Chi68P1/Tennis_Ball_Retrieval_Robot_Project/SW_simulate_ROS/catkin_ws/src/my_robot/meshes/main_wheel.stl

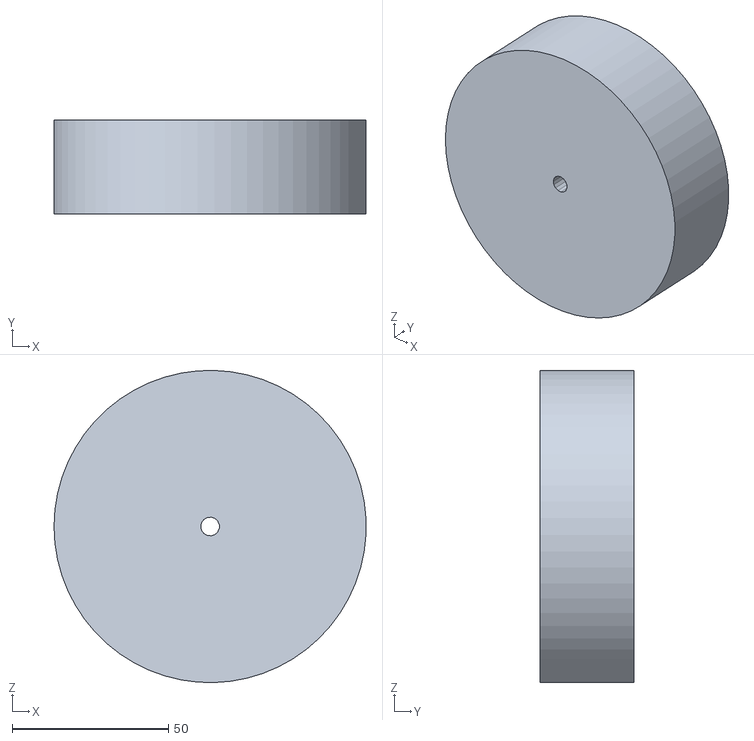
[picture p57: CAD file, 2024-01-08]
SW_simulate_ROS/catkin_ws/src/my_robot/meshes/main_wheel.stl
99.9 x 30.0 x 100.0
