Chi68P1/Tennis_Ball_Retrieval_Robot_Project/SW_simulate_ROS/catkin_ws/src/my_robot/meshes/base1.stl

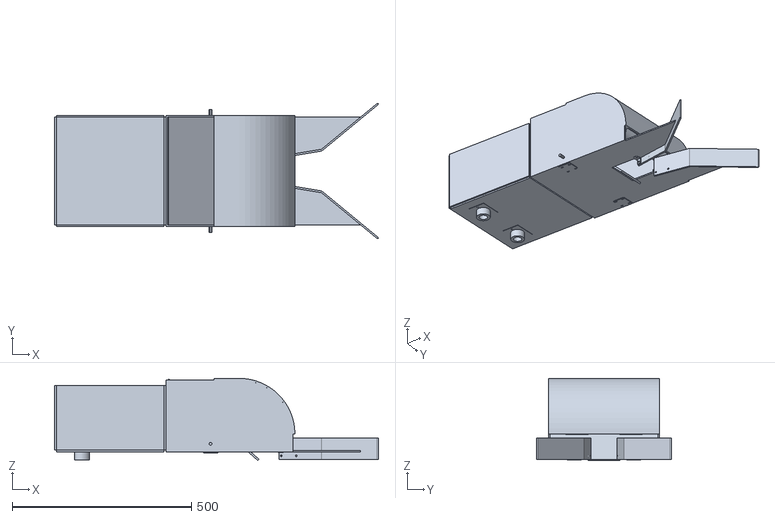
[picture p58: CAD file, 2024-01-08]
SW_simulate_ROS/catkin_ws/src/my_robot/meshes/base1.stl
902.8 x 377.0 x 229.2
