Chi68P1/Tennis_Ball_Retrieval_Robot_Project/SW_simulate_ROS/catkin_ws/src/my_robot/meshes/oriented_wheel.stl

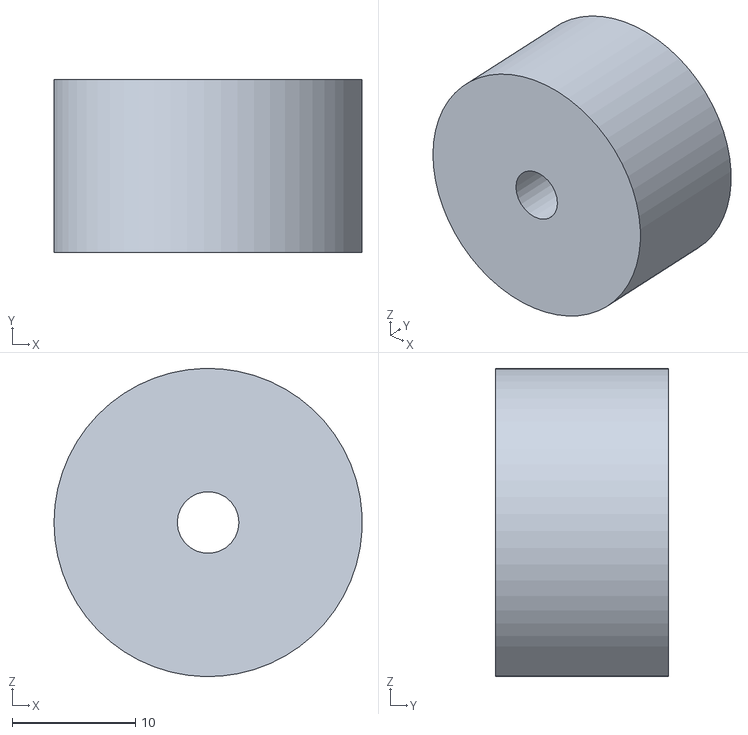
[picture p59: CAD file, 2024-01-08]
SW_simulate_ROS/catkin_ws/src/my_robot/meshes/oriented_wheel.stl
25.0 x 14.0 x 25.0
