Chi68P1/Tennis_Ball_Retrieval_Robot_Project/SW_simulate_ROS/catkin_ws/src/my_robot/meshes/base0.stl

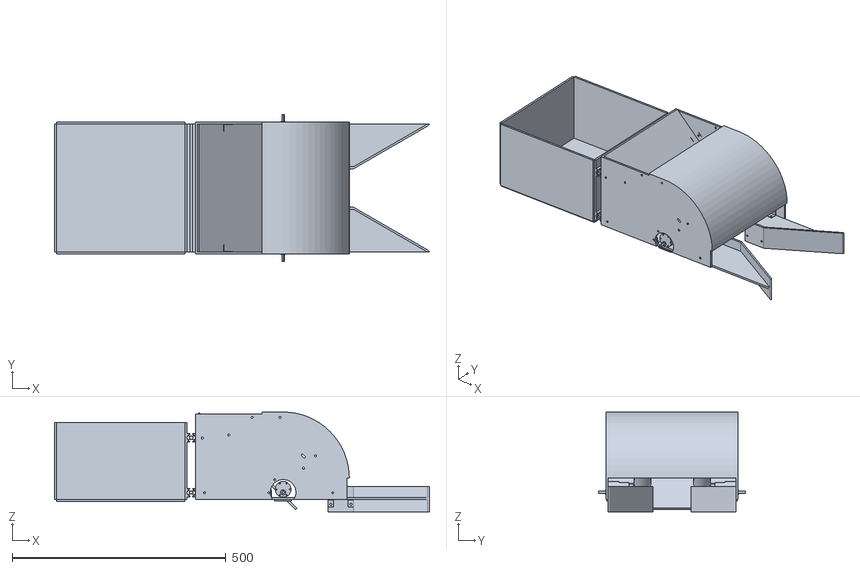
[picture p60: CAD file, 2024-01-08]
SW_simulate_ROS/catkin_ws/src/my_robot/meshes/base0.stl
877.5 x 343.0 x 234.0
