Chi68P1/Tennis_Ball_Retrieval_Robot_Project/SW_simulate_ROS/catkin_ws/src/my_robot/meshes/oriented_link1.stl

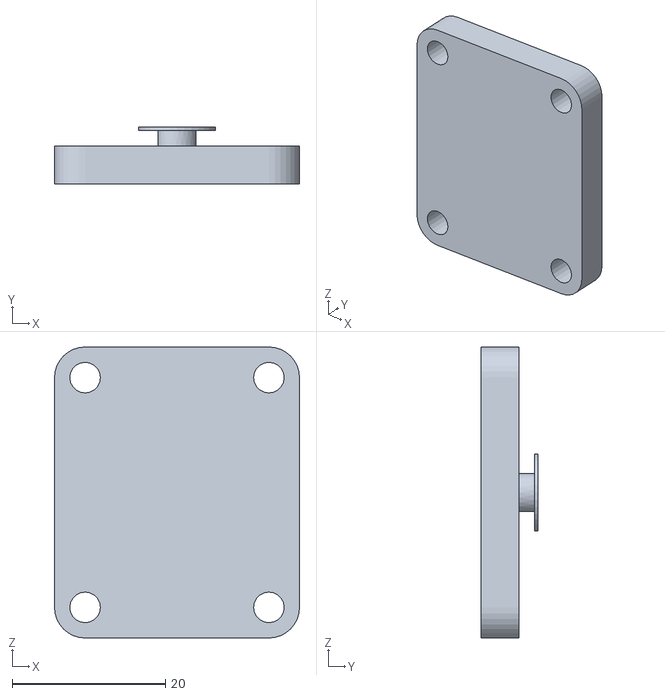
[picture p61: CAD file, 2024-01-08]
SW_simulate_ROS/catkin_ws/src/my_robot/meshes/oriented_link1.stl
32.0 x 7.50 x 38.0
