Chi68P1/Tennis_Ball_Retrieval_Robot_Project/SW_simulate_ROS/catkin_ws/src/my_robot/meshes/base3.stl

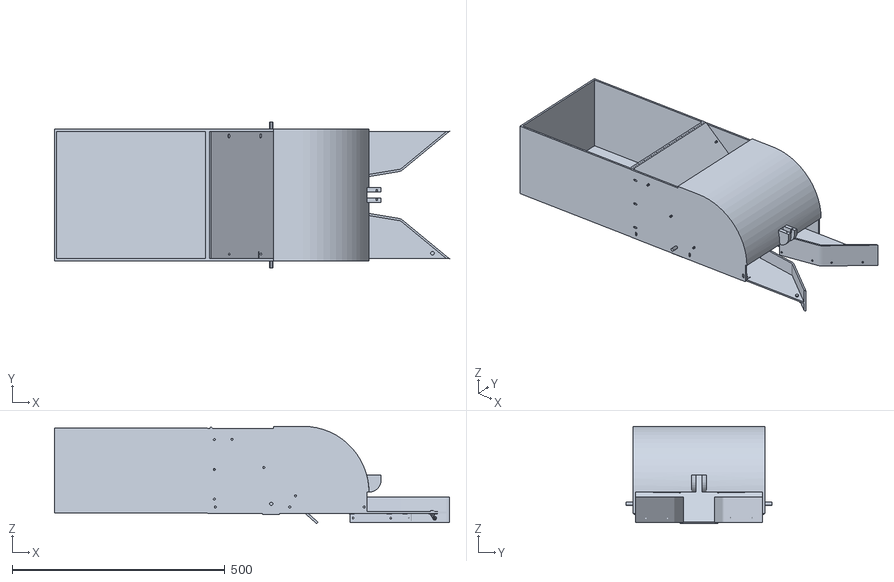
[picture p63: CAD file, 2024-01-08]
SW_simulate_ROS/catkin_ws/src/my_robot/meshes/base3.stl
929.4 x 344.0 x 229.2
