Chi68P1/Tennis_Ball_Retrieval_Robot_Project/SW_simulate_ROS/catkin_ws/src/my_robot/meshes/base2.stl

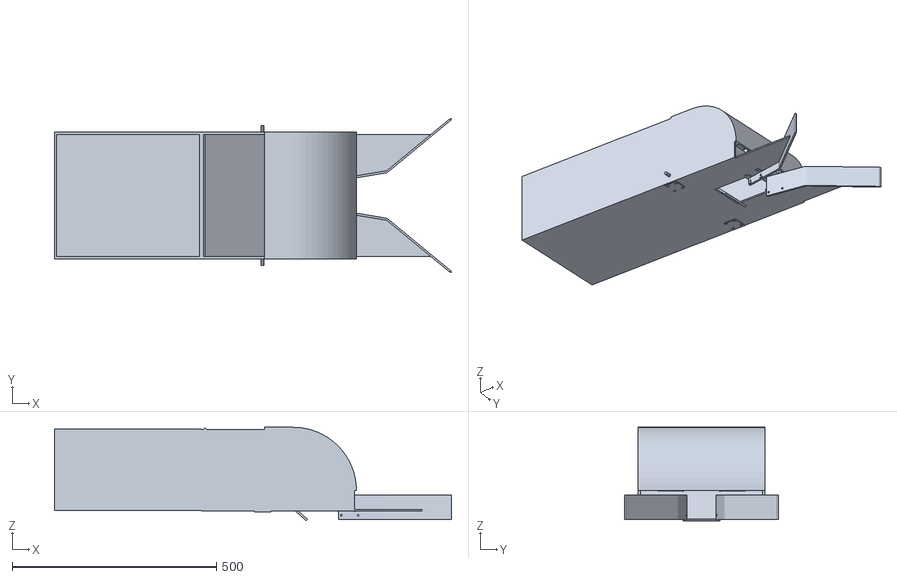
[picture p64: CAD file, 2024-01-08]
SW_simulate_ROS/catkin_ws/src/my_robot/meshes/base2.stl
972.8 x 377.0 x 229.2
