Chi68P1/Tennis_Ball_Retrieval_Robot_Project/SW_simulate_ROS/catkin_ws/src/my_robot/meshes/shooting_wheel.stl

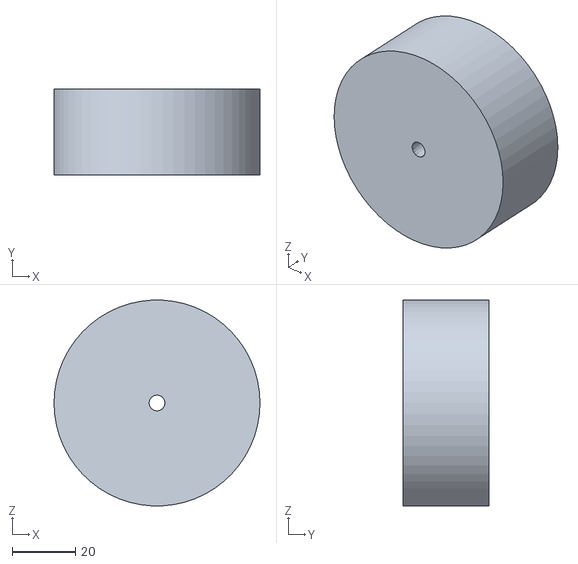
[picture p65: CAD file, 2024-01-08]
SW_simulate_ROS/catkin_ws/src/my_robot/meshes/shooting_wheel.stl
65.0 x 27.0 x 64.9
