Chi68P1/Tennis_Ball_Retrieval_Robot_Project/SW_simulate_ROS/catkin_ws/src/my_robot/meshes/oriented_link2.stl

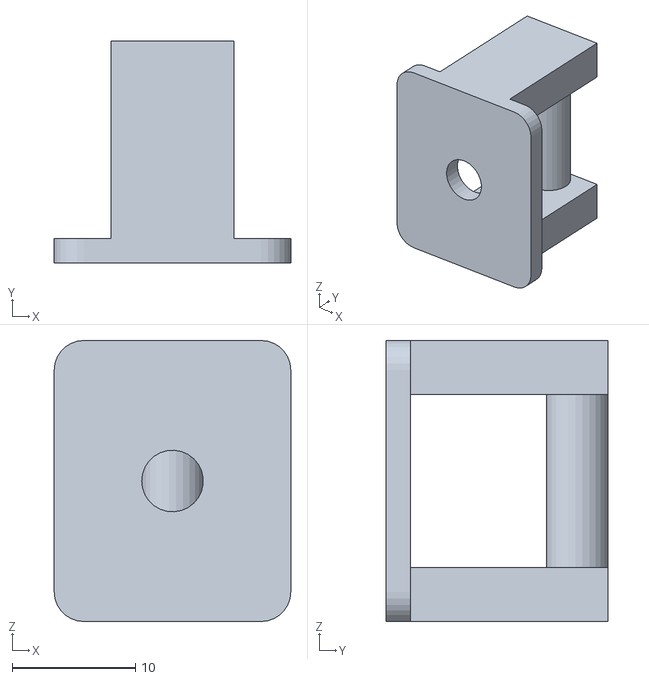
[picture p66: CAD file, 2024-01-08]
SW_simulate_ROS/catkin_ws/src/my_robot/meshes/oriented_link2.stl
19.2 x 18.0 x 22.8
