Chi68P1/Tennis_Ball_Retrieval_Robot_Project/SW_stm32/Manual_stm_1/MDK-ARM/TRR_main/TRR_main.htm

# Static Call Graph for image TRR_main\TRR_main.axf

#<CALLGRAPH># ARM Linker, 5060960: Last Updated: Mon Dec 25 12:03:44 2023

### Maximum Stack Usage = 192 bytes + Unknown(Functions without stacksize, Cycles, Untraceable Function Pointers)

### Call chain for Maximum Stack Depth:

USB_LP_CAN1_RX0_IRQHandler ⇒ HAL_PCD_IRQHandler ⇒ PCD_EP_ISR_Handler ⇒ HAL_PCD_EP_DB_Transmit ⇒ HAL_PCD_DataInStageCallback ⇒ USBD_LL_DataInStage ⇒ USBD_CtlReceiveStatus ⇒ USBD_LL_PrepareReceive ⇒ HAL_PCD_EP_Receive ⇒ USB_EPStartXfer ⇒ USB_WritePMA

### Functions with no stack information

- __user_initial_stackheap

### Mutually Recursive functions

- ADC1_2_IRQHandler ⇒ ADC1_2_IRQHandler
- BusFault_Handler ⇒ BusFault_Handler
- HardFault_Handler ⇒ HardFault_Handler
- MemManage_Handler ⇒ MemManage_Handler
- NMI_Handler ⇒ NMI_Handler
- UART_EndRxTransfer ⇒ UART_EndRxTransfer
- UsageFault_Handler ⇒ UsageFault_Handler

### Function Pointers

- ADC1_2_IRQHandler from startup_stm32f103xb.o(.text) referenced from startup_stm32f103xb.o(RESET)
- BusFault_Handler from stm32f1xx_it.o(i.BusFault_Handler) referenced from startup_stm32f103xb.o(RESET)
- CAN1_RX1_IRQHandler from startup_stm32f103xb.o(.text) referenced from startup_stm32f103xb.o(RESET)
- CAN1_SCE_IRQHandler from startup_stm32f103xb.o(.text) referenced from startup_stm32f103xb.o(RESET)
- CDC_Control_FS from usbd_cdc_if.o(i.CDC_Control_FS) referenced 2 times from usbd_cdc_if.o(.data)
- CDC_DeInit_FS from usbd_cdc_if.o(i.CDC_DeInit_FS) referenced 2 times from usbd_cdc_if.o(.data)
- CDC_Init_FS from usbd_cdc_if.o(i.CDC_Init_FS) referenced 2 times from usbd_cdc_if.o(.data)
- CDC_Receive_FS from usbd_cdc_if.o(i.CDC_Receive_FS) referenced 2 times from usbd_cdc_if.o(.data)
- DMA1_Channel1_IRQHandler from startup_stm32f103xb.o(.text) referenced from startup_stm32f103xb.o(RESET)
- DMA1_Channel2_IRQHandler from startup_stm32f103xb.o(.text) referenced from startup_stm32f103xb.o(RESET)
- DMA1_Channel3_IRQHandler from startup_stm32f103xb.o(.text) referenced from startup_stm32f103xb.o(RESET)
- DMA1_Channel4_IRQHandler from startup_stm32f103xb.o(.text) referenced from startup_stm32f103xb.o(RESET)
- DMA1_Channel5_IRQHandler from startup_stm32f103xb.o(.text) referenced from startup_stm32f103xb.o(RESET)
- DMA1_Channel6_IRQHandler from startup_stm32f103xb.o(.text) referenced from startup_stm32f103xb.o(RESET)
- DMA1_Channel7_IRQHandler from startup_stm32f103xb.o(.text) referenced from startup_stm32f103xb.o(RESET)
- DebugMon_Handler from stm32f1xx_it.o(i.DebugMon_Handler) referenced from startup_stm32f103xb.o(RESET)
- EXTI0_IRQHandler from startup_stm32f103xb.o(.text) referenced from startup_stm32f103xb.o(RESET)
- EXTI15_10_IRQHandler from startup_stm32f103xb.o(.text) referenced from startup_stm32f103xb.o(RESET)
- EXTI1_IRQHandler from startup_stm32f103xb.o(.text) referenced from startup_stm32f103xb.o(RESET)
- EXTI2_IRQHandler from startup_stm32f103xb.o(.text) referenced from startup_stm32f103xb.o(RESET)
- EXTI3_IRQHandler from startup_stm32f103xb.o(.text) referenced from startup_stm32f103xb.o(RESET)
- EXTI4_IRQHandler from startup_stm32f103xb.o(.text) referenced from startup_stm32f103xb.o(RESET)
- EXTI9_5_IRQHandler from startup_stm32f103xb.o(.text) referenced from startup_stm32f103xb.o(RESET)
- FLASH_IRQHandler from startup_stm32f103xb.o(.text) referenced from startup_stm32f103xb.o(RESET)
- HardFault_Handler from stm32f1xx_it.o(i.HardFault_Handler) referenced from startup_stm32f103xb.o(RESET)
- I2C1_ER_IRQHandler from startup_stm32f103xb.o(.text) referenced from startup_stm32f103xb.o(RESET)
- I2C1_EV_IRQHandler from startup_stm32f103xb.o(.text) referenced from startup_stm32f103xb.o(RESET)
- I2C2_ER_IRQHandler from startup_stm32f103xb.o(.text) referenced from startup_stm32f103xb.o(RESET)
- I2C2_EV_IRQHandler from startup_stm32f103xb.o(.text) referenced from startup_stm32f103xb.o(RESET)
- MemManage_Handler from stm32f1xx_it.o(i.MemManage_Handler) referenced from startup_stm32f103xb.o(RESET)
- NMI_Handler from stm32f1xx_it.o(i.NMI_Handler) referenced from startup_stm32f103xb.o(RESET)
- PVD_IRQHandler from startup_stm32f103xb.o(.text) referenced from startup_stm32f103xb.o(RESET)
- PendSV_Handler from stm32f1xx_it.o(i.PendSV_Handler) referenced from startup_stm32f103xb.o(RESET)
- RCC_IRQHandler from startup_stm32f103xb.o(.text) referenced from startup_stm32f103xb.o(RESET)
- RTC_Alarm_IRQHandler from startup_stm32f103xb.o(.text) referenced from startup_stm32f103xb.o(RESET)
- RTC_IRQHandler from startup_stm32f103xb.o(.text) referenced from startup_stm32f103xb.o(RESET)
- Reset_Handler from startup_stm32f103xb.o(.text) referenced from startup_stm32f103xb.o(RESET)
- SPI1_IRQHandler from startup_stm32f103xb.o(.text) referenced from startup_stm32f103xb.o(RESET)
- SPI2_IRQHandler from startup_stm32f103xb.o(.text) referenced from startup_stm32f103xb.o(RESET)
- SVC_Handler from stm32f1xx_it.o(i.SVC_Handler) referenced from startup_stm32f103xb.o(RESET)
- SysTick_Handler from stm32f1xx_it.o(i.SysTick_Handler) referenced from startup_stm32f103xb.o(RESET)
- SystemInit from system_stm32f1xx.o(i.SystemInit) referenced from startup_stm32f103xb.o(.text)
- TAMPER_IRQHandler from startup_stm32f103xb.o(.text) referenced from startup_stm32f103xb.o(RESET)
- TIM1_BRK_IRQHandler from startup_stm32f103xb.o(.text) referenced from startup_stm32f103xb.o(RESET)
- TIM1_CC_IRQHandler from startup_stm32f103xb.o(.text) referenced from startup_stm32f103xb.o(RESET)
- TIM1_TRG_COM_IRQHandler from startup_stm32f103xb.o(.text) referenced from startup_stm32f103xb.o(RESET)
- TIM1_UP_IRQHandler from startup_stm32f103xb.o(.text) referenced from startup_stm32f103xb.o(RESET)
- TIM2_IRQHandler from startup_stm32f103xb.o(.text) referenced from startup_stm32f103xb.o(RESET)
- TIM3_IRQHandler from stm32f1xx_it.o(i.TIM3_IRQHandler) referenced from startup_stm32f103xb.o(RESET)
- TIM4_IRQHandler from startup_stm32f103xb.o(.text) referenced from startup_stm32f103xb.o(RESET)
- UART_DMAAbortOnError from stm32f1xx_hal_uart.o(i.UART_DMAAbortOnError) referenced from stm32f1xx_hal_uart.o(i.HAL_UART_IRQHandler)
- USART1_IRQHandler from startup_stm32f103xb.o(.text) referenced from startup_stm32f103xb.o(RESET)
- USART2_IRQHandler from startup_stm32f103xb.o(.text) referenced from startup_stm32f103xb.o(RESET)
- USART3_IRQHandler from stm32f1xx_it.o(i.USART3_IRQHandler) referenced from startup_stm32f103xb.o(RESET)
- USBD_CDC_DataIn from usbd_cdc.o(i.USBD_CDC_DataIn) referenced 2 times from usbd_cdc.o(.data)
- USBD_CDC_DataOut from usbd_cdc.o(i.USBD_CDC_DataOut) referenced 2 times from usbd_cdc.o(.data)
- USBD_CDC_DeInit from usbd_cdc.o(i.USBD_CDC_DeInit) referenced 2 times from usbd_cdc.o(.data)
- USBD_CDC_EP0_RxReady from usbd_cdc.o(i.USBD_CDC_EP0_RxReady) referenced 2 times from usbd_cdc.o(.data)
- USBD_CDC_GetDeviceQualifierDescriptor from usbd_cdc.o(i.USBD_CDC_GetDeviceQualifierDescriptor) referenced 2 times from usbd_cdc.o(.data)
- USBD_CDC_GetFSCfgDesc from usbd_cdc.o(i.USBD_CDC_GetFSCfgDesc) referenced 2 times from usbd_cdc.o(.data)
- USBD_CDC_GetHSCfgDesc from usbd_cdc.o(i.USBD_CDC_GetHSCfgDesc) referenced 2 times from usbd_cdc.o(.data)
- USBD_CDC_GetOtherSpeedCfgDesc from usbd_cdc.o(i.USBD_CDC_GetOtherSpeedCfgDesc) referenced 2 times from usbd_cdc.o(.data)
- USBD_CDC_Init from usbd_cdc.o(i.USBD_CDC_Init) referenced 2 times from usbd_cdc.o(.data)
- USBD_CDC_Setup from usbd_cdc.o(i.USBD_CDC_Setup) referenced 2 times from usbd_cdc.o(.data)
- USBD_FS_ConfigStrDescriptor from usbd_desc.o(i.USBD_FS_ConfigStrDescriptor) referenced 2 times from usbd_desc.o(.data)
- USBD_FS_DeviceDescriptor from usbd_desc.o(i.USBD_FS_DeviceDescriptor) referenced 2 times from usbd_desc.o(.data)
- USBD_FS_InterfaceStrDescriptor from usbd_desc.o(i.USBD_FS_InterfaceStrDescriptor) referenced 2 times from usbd_desc.o(.data)
- USBD_FS_LangIDStrDescriptor from usbd_desc.o(i.USBD_FS_LangIDStrDescriptor) referenced 2 times from usbd_desc.o(.data)
- USBD_FS_ManufacturerStrDescriptor from usbd_desc.o(i.USBD_FS_ManufacturerStrDescriptor) referenced 2 times from usbd_desc.o(.data)
- USBD_FS_ProductStrDescriptor from usbd_desc.o(i.USBD_FS_ProductStrDescriptor) referenced 2 times from usbd_desc.o(.data)
- USBD_FS_SerialStrDescriptor from usbd_desc.o(i.USBD_FS_SerialStrDescriptor) referenced 2 times from usbd_desc.o(.data)
- USBWakeUp_IRQHandler from startup_stm32f103xb.o(.text) referenced from startup_stm32f103xb.o(RESET)
- USB_HP_CAN1_TX_IRQHandler from startup_stm32f103xb.o(.text) referenced from startup_stm32f103xb.o(RESET)
- USB_LP_CAN1_RX0_IRQHandler from stm32f1xx_it.o(i.USB_LP_CAN1_RX0_IRQHandler) referenced from startup_stm32f103xb.o(RESET)
- UsageFault_Handler from stm32f1xx_it.o(i.UsageFault_Handler) referenced from startup_stm32f103xb.o(RESET)
- WWDG_IRQHandler from startup_stm32f103xb.o(.text) referenced from startup_stm32f103xb.o(RESET)
- __main from __main.o(!!!main) referenced from startup_stm32f103xb.o(.text)

### Global Symbols

__main (Thumb, 8 bytes, Stack size 0 bytes, __main.o(!!!main))

[Calls]

- >> __scatterload
- >> __rt_entry

__scatterload (Thumb, 0 bytes, Stack size unknown bytes, __scatter.o(!!!scatter))

[Called By]

- >> __main

__scatterload_rt2 (Thumb, 44 bytes, Stack size unknown bytes, __scatter.o(!!!scatter), UNUSED)

[Calls]

- >> __rt_entry

__scatterload_rt2_thumb_only (Thumb, 0 bytes, Stack size unknown bytes, __scatter.o(!!!scatter), UNUSED)

__scatterload_null (Thumb, 0 bytes, Stack size unknown bytes, __scatter.o(!!!scatter), UNUSED)

__decompress (Thumb, 90 bytes, Stack size unknown bytes, __dczerorl2.o(!!dczerorl2), UNUSED)

__decompress1 (Thumb, 0 bytes, Stack size unknown bytes, __dczerorl2.o(!!dczerorl2), UNUSED)

__scatterload_zeroinit (Thumb, 28 bytes, Stack size unknown bytes, __scatter_zi.o(!!handler_zi), UNUSED)

__rt_lib_init (Thumb, 0 bytes, Stack size unknown bytes, libinit.o(.ARM.Collect$$libinit$$00000000))

[Called By]

- >> __rt_entry_li

__rt_lib_init_alloca_1 (Thumb, 0 bytes, Stack size unknown bytes, libinit2.o(.ARM.Collect$$libinit$$0000002E))

__rt_lib_init_argv_1 (Thumb, 0 bytes, Stack size unknown bytes, libinit2.o(.ARM.Collect$$libinit$$0000002C))

__rt_lib_init_atexit_1 (Thumb, 0 bytes, Stack size unknown bytes, libinit2.o(.ARM.Collect$$libinit$$0000001B))

__rt_lib_init_clock_1 (Thumb, 0 bytes, Stack size unknown bytes, libinit2.o(.ARM.Collect$$libinit$$00000021))

__rt_lib_init_cpp_1 (Thumb, 0 bytes, Stack size unknown bytes, libinit2.o(.ARM.Collect$$libinit$$00000032))

__rt_lib_init_exceptions_1 (Thumb, 0 bytes, Stack size unknown bytes, libinit2.o(.ARM.Collect$$libinit$$00000030))

__rt_lib_init_fp_1 (Thumb, 0 bytes, Stack size unknown bytes, libinit2.o(.ARM.Collect$$libinit$$00000002))

__rt_lib_init_fp_trap_1 (Thumb, 0 bytes, Stack size unknown bytes, libinit2.o(.ARM.Collect$$libinit$$0000001F))

__rt_lib_init_getenv_1 (Thumb, 0 bytes, Stack size unknown bytes, libinit2.o(.ARM.Collect$$libinit$$00000023))

__rt_lib_init_heap_1 (Thumb, 0 bytes, Stack size unknown bytes, libinit2.o(.ARM.Collect$$libinit$$0000000A))

__rt_lib_init_lc_collate_1 (Thumb, 0 bytes, Stack size unknown bytes, libinit2.o(.ARM.Collect$$libinit$$00000011))

__rt_lib_init_lc_ctype_1 (Thumb, 0 bytes, Stack size unknown bytes, libinit2.o(.ARM.Collect$$libinit$$00000013))

__rt_lib_init_lc_monetary_1 (Thumb, 0 bytes, Stack size unknown bytes, libinit2.o(.ARM.Collect$$libinit$$00000015))

__rt_lib_init_lc_numeric_1 (Thumb, 0 bytes, Stack size unknown bytes, libinit2.o(.ARM.Collect$$libinit$$00000017))

__rt_lib_init_lc_time_1 (Thumb, 0 bytes, Stack size unknown bytes, libinit2.o(.ARM.Collect$$libinit$$00000019))

__rt_lib_init_preinit_1 (Thumb, 0 bytes, Stack size unknown bytes, libinit2.o(.ARM.Collect$$libinit$$00000004))

__rt_lib_init_rand_1 (Thumb, 0 bytes, Stack size unknown bytes, libinit2.o(.ARM.Collect$$libinit$$0000000E))

__rt_lib_init_return (Thumb, 0 bytes, Stack size unknown bytes, libinit2.o(.ARM.Collect$$libinit$$00000033))

__rt_lib_init_signal_1 (Thumb, 0 bytes, Stack size unknown bytes, libinit2.o(.ARM.Collect$$libinit$$0000001D))

__rt_lib_init_stdio_1 (Thumb, 0 bytes, Stack size unknown bytes, libinit2.o(.ARM.Collect$$libinit$$00000025))

__rt_lib_init_user_alloc_1 (Thumb, 0 bytes, Stack size unknown bytes, libinit2.o(.ARM.Collect$$libinit$$0000000C))

__rt_lib_shutdown (Thumb, 0 bytes, Stack size unknown bytes, libshutdown.o(.ARM.Collect$$libshutdown$$00000000))

[Called By]

- >> __rt_exit_ls

__rt_lib_shutdown_cpp_1 (Thumb, 0 bytes, Stack size unknown bytes, libshutdown2.o(.ARM.Collect$$libshutdown$$00000004))

__rt_lib_shutdown_fini_1 (Thumb, 0 bytes, Stack size unknown bytes, libshutdown2.o(.ARM.Collect$$libshutdown$$00000002))

__rt_lib_shutdown_fp_trap_1 (Thumb, 0 bytes, Stack size unknown bytes, libshutdown2.o(.ARM.Collect$$libshutdown$$00000009))

__rt_lib_shutdown_heap_1 (Thumb, 0 bytes, Stack size unknown bytes, libshutdown2.o(.ARM.Collect$$libshutdown$$00000011))

__rt_lib_shutdown_return (Thumb, 0 bytes, Stack size unknown bytes, libshutdown2.o(.ARM.Collect$$libshutdown$$00000012))

__rt_lib_shutdown_signal_1 (Thumb, 0 bytes, Stack size unknown bytes, libshutdown2.o(.ARM.Collect$$libshutdown$$0000000C))

__rt_lib_shutdown_stdio_1 (Thumb, 0 bytes, Stack size unknown bytes, libshutdown2.o(.ARM.Collect$$libshutdown$$00000006))

__rt_lib_shutdown_user_alloc_1 (Thumb, 0 bytes, Stack size unknown bytes, libshutdown2.o(.ARM.Collect$$libshutdown$$0000000E))

__rt_entry (Thumb, 0 bytes, Stack size unknown bytes, __rtentry.o(.ARM.Collect$$rtentry$$00000000))

[Called By]

- >> __scatterload_rt2
- >> __main

__rt_entry_presh_1 (Thumb, 0 bytes, Stack size unknown bytes, __rtentry2.o(.ARM.Collect$$rtentry$$00000002))

__rt_entry_sh (Thumb, 0 bytes, Stack size unknown bytes, __rtentry4.o(.ARM.Collect$$rtentry$$00000004))

[Stack]

- Max Depth = 8 + Unknown Stack Size
- Call Chain = __rt_entry_sh ⇒ __user_setup_stackheap

[Calls]

- >> __user_setup_stackheap

__rt_entry_li (Thumb, 0 bytes, Stack size unknown bytes, __rtentry2.o(.ARM.Collect$$rtentry$$0000000A))

[Calls]

- >> __rt_lib_init

__rt_entry_postsh_1 (Thumb, 0 bytes, Stack size unknown bytes, __rtentry2.o(.ARM.Collect$$rtentry$$00000009))

__rt_entry_main (Thumb, 0 bytes, Stack size unknown bytes, __rtentry2.o(.ARM.Collect$$rtentry$$0000000D))

[Stack]

- Max Depth = 152 + Unknown Stack Size
- Call Chain = __rt_entry_main ⇒ main ⇒ SystemClock_Config ⇒ HAL_RCC_ClockConfig ⇒ HAL_InitTick ⇒ HAL_NVIC_SetPriority

[Calls]

- >> main
- >> exit

__rt_entry_postli_1 (Thumb, 0 bytes, Stack size unknown bytes, __rtentry2.o(.ARM.Collect$$rtentry$$0000000C))

__rt_exit (Thumb, 0 bytes, Stack size unknown bytes, rtexit.o(.ARM.Collect$$rtexit$$00000000))

[Called By]

- >> exit

__rt_exit_ls (Thumb, 0 bytes, Stack size unknown bytes, rtexit2.o(.ARM.Collect$$rtexit$$00000003))

[Calls]

- >> __rt_lib_shutdown

__rt_exit_prels_1 (Thumb, 0 bytes, Stack size unknown bytes, rtexit2.o(.ARM.Collect$$rtexit$$00000002))

__rt_exit_exit (Thumb, 0 bytes, Stack size unknown bytes, rtexit2.o(.ARM.Collect$$rtexit$$00000004))

[Calls]

- >> _sys_exit

Reset_Handler (Thumb, 8 bytes, Stack size 0 bytes, startup_stm32f103xb.o(.text))
[Address Reference Count : 1]

- startup_stm32f103xb.o(RESET)

ADC1_2_IRQHandler (Thumb, 0 bytes, Stack size 0 bytes, startup_stm32f103xb.o(.text))

[Calls]

- >> ADC1_2_IRQHandler

[Called By]

- >> ADC1_2_IRQHandler

[Address Reference Count : 1]

- startup_stm32f103xb.o(RESET)

CAN1_RX1_IRQHandler (Thumb, 0 bytes, Stack size 0 bytes, startup_stm32f103xb.o(.text))
[Address Reference Count : 1]

- startup_stm32f103xb.o(RESET)

CAN1_SCE_IRQHandler (Thumb, 0 bytes, Stack size 0 bytes, startup_stm32f103xb.o(.text))
[Address Reference Count : 1]

- startup_stm32f103xb.o(RESET)

DMA1_Channel1_IRQHandler (Thumb, 0 bytes, Stack size 0 bytes, startup_stm32f103xb.o(.text))
[Address Reference Count : 1]

- startup_stm32f103xb.o(RESET)

DMA1_Channel2_IRQHandler (Thumb, 0 bytes, Stack size 0 bytes, startup_stm32f103xb.o(.text))
[Address Reference Count : 1]

- startup_stm32f103xb.o(RESET)

DMA1_Channel3_IRQHandler (Thumb, 0 bytes, Stack size 0 bytes, startup_stm32f103xb.o(.text))
[Address Reference Count : 1]

- startup_stm32f103xb.o(RESET)

DMA1_Channel4_IRQHandler (Thumb, 0 bytes, Stack size 0 bytes, startup_stm32f103xb.o(.text))
[Address Reference Count : 1]

- startup_stm32f103xb.o(RESET)

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

USART1_IRQHandler (Thumb, 0 bytes, Stack size 0 bytes, startup_stm32f103xb.o(.text))
[Address Reference Count : 1]

- startup_stm32f103xb.o(RESET)

USART2_IRQHandler (Thumb, 0 bytes, Stack size 0 bytes, startup_stm32f103xb.o(.text))
[Address Reference Count : 1]

- startup_stm32f103xb.o(RESET)

USBWakeUp_IRQHandler (Thumb, 0 bytes, Stack size 0 bytes, startup_stm32f103xb.o(.text))
[Address Reference Count : 1]

- startup_stm32f103xb.o(RESET)

USB_HP_CAN1_TX_IRQHandler (Thumb, 0 bytes, Stack size 0 bytes, startup_stm32f103xb.o(.text))
[Address Reference Count : 1]

- startup_stm32f103xb.o(RESET)

WWDG_IRQHandler (Thumb, 0 bytes, Stack size 0 bytes, startup_stm32f103xb.o(.text))
[Address Reference Count : 1]

- startup_stm32f103xb.o(RESET)

__user_initial_stackheap (Thumb, 0 bytes, Stack size unknown bytes, startup_stm32f103xb.o(.text))

[Called By]

- >> __user_setup_stackheap

__aeabi_memcpy (Thumb, 0 bytes, Stack size 0 bytes, rt_memcpy_v6.o(.text))

[Called By]

- >> CDC_Receive_FS

__rt_memcpy (Thumb, 138 bytes, Stack size 0 bytes, rt_memcpy_v6.o(.text), UNUSED)

[Calls]

- >> __aeabi_memcpy4

_memcpy_lastbytes (Thumb, 0 bytes, Stack size unknown bytes, rt_memcpy_v6.o(.text), UNUSED)

__aeabi_memcpy4 (Thumb, 0 bytes, Stack size 8 bytes, rt_memcpy_w.o(.text))

[Stack]

- Max Depth = 8
- Call Chain = __aeabi_memcpy4

[Called By]

- >> HAL_PCD_Init
- >> __rt_memcpy

__aeabi_memcpy8 (Thumb, 0 bytes, Stack size 8 bytes, rt_memcpy_w.o(.text), UNUSED)

__rt_memcpy_w (Thumb, 100 bytes, Stack size 8 bytes, rt_memcpy_w.o(.text), UNUSED)

_memcpy_lastbytes_aligned (Thumb, 0 bytes, Stack size unknown bytes, rt_memcpy_w.o(.text), UNUSED)

__aeabi_memclr (Thumb, 0 bytes, Stack size 0 bytes, rt_memclr.o(.text))

[Called By]

- >> CDC_Receive_FS

__rt_memclr (Thumb, 68 bytes, Stack size 0 bytes, rt_memclr.o(.text), UNUSED)

[Calls]

- >> _memset_w

_memset (Thumb, 0 bytes, Stack size unknown bytes, rt_memclr.o(.text), UNUSED)

__aeabi_memclr4 (Thumb, 0 bytes, Stack size 4 bytes, rt_memclr_w.o(.text))

[Stack]

- Max Depth = 4
- Call Chain = __aeabi_memclr4

[Called By]

- >> SystemClock_Config
- >> MX_TIM4_Init
- >> MX_TIM2_Init
- >> MX_TIM1_Init

__aeabi_memclr8 (Thumb, 0 bytes, Stack size 4 bytes, rt_memclr_w.o(.text), UNUSED)

__rt_memclr_w (Thumb, 78 bytes, Stack size 4 bytes, rt_memclr_w.o(.text), UNUSED)

_memset_w (Thumb, 0 bytes, Stack size unknown bytes, rt_memclr_w.o(.text), UNUSED)

[Called By]

- >> __rt_memclr

__use_two_region_memory (Thumb, 2 bytes, Stack size 0 bytes, heapauxi.o(.text), UNUSED)

__rt_heap_escrow$2region (Thumb, 2 bytes, Stack size 0 bytes, heapauxi.o(.text), UNUSED)

__rt_heap_expand$2region (Thumb, 2 bytes, Stack size 0 bytes, heapauxi.o(.text), UNUSED)

__user_setup_stackheap (Thumb, 74 bytes, Stack size 8 bytes, sys_stackheap_outer.o(.text))

[Stack]

- Max Depth = 8 + Unknown Stack Size
- Call Chain = __user_setup_stackheap

[Calls]

- >> __user_initial_stackheap
- >> __user_perproc_libspace

[Called By]

- >> __rt_entry_sh

exit (Thumb, 18 bytes, Stack size 8 bytes, exit.o(.text))

[Stack]

- Max Depth = 8 + Unknown Stack Size
- Call Chain = exit

[Calls]

- >> __rt_exit

[Called By]

- >> __rt_entry_main

__user_libspace (Thumb, 8 bytes, Stack size 0 bytes, libspace.o(.text), UNUSED)

__user_perproc_libspace (Thumb, 0 bytes, Stack size 0 bytes, libspace.o(.text))

[Called By]

- >> __user_setup_stackheap

__user_perthread_libspace (Thumb, 0 bytes, Stack size 0 bytes, libspace.o(.text), UNUSED)

_sys_exit (Thumb, 8 bytes, Stack size 0 bytes, sys_exit.o(.text))

[Called By]

- >> __rt_exit_exit

__I$use$semihosting (Thumb, 0 bytes, Stack size 0 bytes, use_no_semi.o(.text), UNUSED)

__use_no_semihosting_swi (Thumb, 2 bytes, Stack size 0 bytes, use_no_semi.o(.text), UNUSED)

BusFault_Handler (Thumb, 2 bytes, Stack size 0 bytes, stm32f1xx_it.o(i.BusFault_Handler))

[Calls]

- >> BusFault_Handler

[Called By]

- >> BusFault_Handler

[Address Reference Count : 1]

- startup_stm32f103xb.o(RESET)

__semihosting_library_function (Thumb, 0 bytes, Stack size 0 bytes, indicate_semi.o(.text), UNUSED)

DebugMon_Handler (Thumb, 2 bytes, Stack size 0 bytes, stm32f1xx_it.o(i.DebugMon_Handler))
[Address Reference Count : 1]

- startup_stm32f103xb.o(RESET)

Error_Handler (Thumb, 4 bytes, Stack size 0 bytes, main.o(i.Error_Handler))

[Called By]

- >> MX_USB_DEVICE_Init
- >> USBD_LL_Init
- >> HAL_PCD_ResetCallback

HAL_DMA_Abort (Thumb, 70 bytes, Stack size 8 bytes, stm32f1xx_hal_dma.o(i.HAL_DMA_Abort))

[Stack]

- Max Depth = 8
- Call Chain = HAL_DMA_Abort

[Called By]

- >> HAL_UART_IRQHandler

HAL_DMA_Abort_IT (Thumb, 148 bytes, Stack size 8 bytes, stm32f1xx_hal_dma.o(i.HAL_DMA_Abort_IT))

[Stack]

- Max Depth = 8
- Call Chain = HAL_DMA_Abort_IT

[Called By]

- >> HAL_UART_IRQHandler

HAL_GPIO_Init (Thumb, 446 bytes, Stack size 40 bytes, stm32f1xx_hal_gpio.o(i.HAL_GPIO_Init))

[Stack]

- Max Depth = 40
- Call Chain = HAL_GPIO_Init

[Called By]

- >> HAL_UART_MspInit
- >> HAL_TIM_Encoder_MspInit
- >> HAL_TIM_MspPostInit
- >> MX_GPIO_Init

HAL_GPIO_WritePin (Thumb, 10 bytes, Stack size 0 bytes, stm32f1xx_hal_gpio.o(i.HAL_GPIO_WritePin))

[Called By]

- >> MotorRightRot
- >> MotorLeftRot
- >> MX_GPIO_Init

HAL_GetTick (Thumb, 6 bytes, Stack size 0 bytes, stm32f1xx_hal.o(i.HAL_GetTick))

[Called By]

- >> HAL_RCC_OscConfig
- >> HAL_RCC_ClockConfig
- >> HAL_RCCEx_PeriphCLKConfig

HAL_IncTick (Thumb, 12 bytes, Stack size 0 bytes, stm32f1xx_hal.o(i.HAL_IncTick))

[Called By]

- >> SysTick_Handler

HAL_Init (Thumb, 32 bytes, Stack size 8 bytes, stm32f1xx_hal.o(i.HAL_Init))

[Stack]

- Max Depth = 40
- Call Chain = HAL_Init ⇒ HAL_InitTick ⇒ HAL_NVIC_SetPriority

[Calls]

- >> HAL_MspInit
- >> HAL_InitTick
- >> HAL_NVIC_SetPriorityGrouping

[Called By]

- >> main

HAL_InitTick (Thumb, 54 bytes, Stack size 16 bytes, stm32f1xx_hal.o(i.HAL_InitTick))

[Stack]

- Max Depth = 32
- Call Chain = HAL_InitTick ⇒ HAL_NVIC_SetPriority

[Calls]

- >> HAL_NVIC_SetPriority
- >> HAL_SYSTICK_Config

[Called By]

- >> HAL_RCC_ClockConfig
- >> HAL_Init

HAL_MspInit (Thumb, 52 bytes, Stack size 8 bytes, stm32f1xx_hal_msp.o(i.HAL_MspInit))

[Stack]

- Max Depth = 8
- Call Chain = HAL_MspInit

[Called By]

- >> HAL_Init

HAL_NVIC_EnableIRQ (Thumb, 26 bytes, Stack size 0 bytes, stm32f1xx_hal_cortex.o(i.HAL_NVIC_EnableIRQ))

[Called By]

- >> HAL_UART_MspInit
- >> HAL_TIM_Base_MspInit
- >> HAL_PCD_MspInit

HAL_NVIC_SetPriority (Thumb, 60 bytes, Stack size 16 bytes, stm32f1xx_hal_cortex.o(i.HAL_NVIC_SetPriority))

[Stack]

- Max Depth = 16
- Call Chain = HAL_NVIC_SetPriority

[Calls]

- >> __NVIC_SetPriority

[Called By]

- >> HAL_UART_MspInit
- >> HAL_TIM_Base_MspInit
- >> HAL_PCD_MspInit
- >> HAL_InitTick

HAL_NVIC_SetPriorityGrouping (Thumb, 26 bytes, Stack size 0 bytes, stm32f1xx_hal_cortex.o(i.HAL_NVIC_SetPriorityGrouping))

[Called By]

- >> HAL_Init

HAL_PCDEx_PMAConfig (Thumb, 60 bytes, Stack size 8 bytes, stm32f1xx_hal_pcd_ex.o(i.HAL_PCDEx_PMAConfig))

[Stack]

- Max Depth = 8
- Call Chain = HAL_PCDEx_PMAConfig

[Called By]

- >> USBD_LL_Init

HAL_PCDEx_SetConnectionState (Thumb, 2 bytes, Stack size 0 bytes, usbd_conf.o(i.HAL_PCDEx_SetConnectionState))

[Called By]

- >> HAL_PCD_Start

HAL_PCD_DataInStageCallback (Thumb, 18 bytes, Stack size 0 bytes, usbd_conf.o(i.HAL_PCD_DataInStageCallback))

[Stack]

- Max Depth = 88
- Call Chain = HAL_PCD_DataInStageCallback ⇒ USBD_LL_DataInStage ⇒ USBD_CtlReceiveStatus ⇒ USBD_LL_PrepareReceive ⇒ HAL_PCD_EP_Receive ⇒ USB_EPStartXfer ⇒ USB_WritePMA

[Calls]

- >> USBD_LL_DataInStage

[Called By]

- >> PCD_EP_ISR_Handler
- >> HAL_PCD_EP_DB_Transmit

HAL_PCD_DataOutStageCallback (Thumb, 20 bytes, Stack size 0 bytes, usbd_conf.o(i.HAL_PCD_DataOutStageCallback))

[Stack]

- Max Depth = 80
- Call Chain = HAL_PCD_DataOutStageCallback ⇒ USBD_LL_DataOutStage ⇒ USBD_CtlSendStatus ⇒ USBD_LL_Transmit ⇒ HAL_PCD_EP_Transmit ⇒ USB_EPStartXfer ⇒ USB_WritePMA

[Calls]

- >> USBD_LL_DataOutStage

[Called By]

- >> PCD_EP_ISR_Handler

HAL_PCD_EP_Close (Thumb, 76 bytes, Stack size 16 bytes, stm32f1xx_hal_pcd.o(i.HAL_PCD_EP_Close))

[Stack]

- Max Depth = 44
- Call Chain = HAL_PCD_EP_Close ⇒ USB_DeactivateEndpoint

[Calls]

- >> USB_DeactivateEndpoint

[Called By]

- >> USBD_LL_CloseEP

HAL_PCD_EP_ClrStall (Thumb, 92 bytes, Stack size 16 bytes, stm32f1xx_hal_pcd.o(i.HAL_PCD_EP_ClrStall))

[Stack]

- Max Depth = 28
- Call Chain = HAL_PCD_EP_ClrStall ⇒ USB_EPClearStall

[Calls]

- >> USB_EPClearStall

[Called By]

- >> USBD_LL_ClearStallEP

HAL_PCD_EP_GetRxCount (Thumb, 18 bytes, Stack size 0 bytes, stm32f1xx_hal_pcd.o(i.HAL_PCD_EP_GetRxCount))

[Called By]

- >> USBD_LL_GetRxDataSize

HAL_PCD_EP_Open (Thumb, 90 bytes, Stack size 24 bytes, stm32f1xx_hal_pcd.o(i.HAL_PCD_EP_Open))

[Stack]

- Max Depth = 56
- Call Chain = HAL_PCD_EP_Open ⇒ USB_ActivateEndpoint

[Calls]

- >> USB_ActivateEndpoint

[Called By]

- >> USBD_LL_OpenEP

HAL_PCD_EP_Receive (Thumb, 46 bytes, Stack size 8 bytes, stm32f1xx_hal_pcd.o(i.HAL_PCD_EP_Receive))

[Stack]

- Max Depth = 48
- Call Chain = HAL_PCD_EP_Receive ⇒ USB_EPStartXfer ⇒ USB_WritePMA

[Calls]

- >> USB_EPStartXfer

[Called By]

- >> USBD_LL_PrepareReceive

HAL_PCD_EP_SetStall (Thumb, 114 bytes, Stack size 16 bytes, stm32f1xx_hal_pcd.o(i.HAL_PCD_EP_SetStall))

[Stack]

- Max Depth = 24
- Call Chain = HAL_PCD_EP_SetStall ⇒ USB_EPSetStall

[Calls]

- >> USB_EPSetStall
- >> USB_EP0_OutStart

[Called By]

- >> USBD_LL_StallEP

HAL_PCD_EP_Transmit (Thumb, 48 bytes, Stack size 8 bytes, stm32f1xx_hal_pcd.o(i.HAL_PCD_EP_Transmit))

[Stack]

- Max Depth = 48
- Call Chain = HAL_PCD_EP_Transmit ⇒ USB_EPStartXfer ⇒ USB_WritePMA

[Calls]

- >> USB_EPStartXfer

[Called By]

- >> USBD_LL_Transmit

HAL_PCD_IRQHandler (Thumb, 308 bytes, Stack size 24 bytes, stm32f1xx_hal_pcd.o(i.HAL_PCD_IRQHandler))

[Stack]

- Max Depth = 192
- Call Chain = HAL_PCD_IRQHandler ⇒ PCD_EP_ISR_Handler ⇒ HAL_PCD_EP_DB_Transmit ⇒ HAL_PCD_DataInStageCallback ⇒ USBD_LL_DataInStage ⇒ USBD_CtlReceiveStatus ⇒ USBD_LL_PrepareReceive ⇒ HAL_PCD_EP_Receive ⇒ USB_EPStartXfer ⇒ USB_WritePMA

[Calls]

- >> USB_ReadInterrupts
- >> PCD_EP_ISR_Handler
- >> HAL_PCD_SetAddress
- >> HAL_PCD_SuspendCallback
- >> HAL_PCD_SOFCallback
- >> HAL_PCD_ResumeCallback
- >> HAL_PCD_ResetCallback

[Called By]

- >> USB_LP_CAN1_RX0_IRQHandler

HAL_PCD_Init (Thumb, 218 bytes, Stack size 48 bytes, stm32f1xx_hal_pcd.o(i.HAL_PCD_Init))

[Stack]

- Max Depth = 72
- Call Chain = HAL_PCD_Init ⇒ HAL_PCD_MspInit ⇒ HAL_NVIC_SetPriority

[Calls]

- >> USB_SetCurrentMode
- >> USB_DisableGlobalInt
- >> USB_DevInit
- >> USB_DevDisconnect
- >> USB_CoreInit
- >> HAL_PCD_MspInit
- >> __aeabi_memcpy4

[Called By]

- >> USBD_LL_Init

HAL_PCD_MspInit (Thumb, 50 bytes, Stack size 8 bytes, usbd_conf.o(i.HAL_PCD_MspInit))

[Stack]

- Max Depth = 24
- Call Chain = HAL_PCD_MspInit ⇒ HAL_NVIC_SetPriority

[Calls]

- >> HAL_NVIC_SetPriority
- >> HAL_NVIC_EnableIRQ

[Called By]

- >> HAL_PCD_Init

HAL_PCD_ResetCallback (Thumb, 38 bytes, Stack size 16 bytes, usbd_conf.o(i.HAL_PCD_ResetCallback))

[Stack]

- Max Depth = 96
- Call Chain = HAL_PCD_ResetCallback ⇒ USBD_LL_Reset ⇒ USBD_LL_OpenEP ⇒ HAL_PCD_EP_Open ⇒ USB_ActivateEndpoint

[Calls]

- >> Error_Handler
- >> USBD_LL_SetSpeed
- >> USBD_LL_Reset

[Called By]

- >> HAL_PCD_IRQHandler

HAL_PCD_ResumeCallback (Thumb, 8 bytes, Stack size 0 bytes, usbd_conf.o(i.HAL_PCD_ResumeCallback))

[Calls]

- >> USBD_LL_Resume

[Called By]

- >> HAL_PCD_IRQHandler

HAL_PCD_SOFCallback (Thumb, 8 bytes, Stack size 0 bytes, usbd_conf.o(i.HAL_PCD_SOFCallback))

[Stack]

- Max Depth = 8
- Call Chain = HAL_PCD_SOFCallback ⇒ USBD_LL_SOF

[Calls]

- >> USBD_LL_SOF

[Called By]

- >> HAL_PCD_IRQHandler

HAL_PCD_SetAddress (Thumb, 40 bytes, Stack size 8 bytes, stm32f1xx_hal_pcd.o(i.HAL_PCD_SetAddress))

[Stack]

- Max Depth = 8
- Call Chain = HAL_PCD_SetAddress

[Calls]

- >> USB_SetDevAddress

[Called By]

- >> HAL_PCD_IRQHandler
- >> USBD_LL_SetUSBAddress

HAL_PCD_SetupStageCallback (Thumb, 14 bytes, Stack size 0 bytes, usbd_conf.o(i.HAL_PCD_SetupStageCallback))

[Stack]

- Max Depth = 128
- Call Chain = HAL_PCD_SetupStageCallback ⇒ USBD_LL_SetupStage ⇒ USBD_StdDevReq ⇒ USBD_GetDescriptor ⇒ USBD_CtlSendData ⇒ USBD_LL_Transmit ⇒ HAL_PCD_EP_Transmit ⇒ USB_EPStartXfer ⇒ USB_WritePMA

[Calls]

- >> USBD_LL_SetupStage

[Called By]

- >> PCD_EP_ISR_Handler

HAL_PCD_Start (Thumb, 50 bytes, Stack size 8 bytes, stm32f1xx_hal_pcd.o(i.HAL_PCD_Start))

[Stack]

- Max Depth = 8
- Call Chain = HAL_PCD_Start

[Calls]

- >> USB_EnableGlobalInt
- >> USB_DevConnect
- >> HAL_PCDEx_SetConnectionState

[Called By]

- >> USBD_LL_Start

HAL_PCD_SuspendCallback (Thumb, 30 bytes, Stack size 8 bytes, usbd_conf.o(i.HAL_PCD_SuspendCallback))

[Stack]

- Max Depth = 8
- Call Chain = HAL_PCD_SuspendCallback

[Calls]

- >> USBD_LL_Suspend

[Called By]

- >> HAL_PCD_IRQHandler

HAL_RCCEx_PeriphCLKConfig (Thumb, 224 bytes, Stack size 32 bytes, stm32f1xx_hal_rcc_ex.o(i.HAL_RCCEx_PeriphCLKConfig))

[Stack]

- Max Depth = 32
- Call Chain = HAL_RCCEx_PeriphCLKConfig

[Calls]

- >> HAL_GetTick

[Called By]

- >> SystemClock_Config

HAL_RCC_ClockConfig (Thumb, 280 bytes, Stack size 32 bytes, stm32f1xx_hal_rcc.o(i.HAL_RCC_ClockConfig))

[Stack]

- Max Depth = 64
- Call Chain = HAL_RCC_ClockConfig ⇒ HAL_InitTick ⇒ HAL_NVIC_SetPriority

[Calls]

- >> HAL_RCC_GetSysClockFreq
- >> HAL_InitTick
- >> HAL_GetTick

[Called By]

- >> SystemClock_Config

HAL_RCC_GetPCLK1Freq (Thumb, 20 bytes, Stack size 0 bytes, stm32f1xx_hal_rcc.o(i.HAL_RCC_GetPCLK1Freq))

[Called By]

- >> UART_SetConfig

HAL_RCC_GetPCLK2Freq (Thumb, 20 bytes, Stack size 0 bytes, stm32f1xx_hal_rcc.o(i.HAL_RCC_GetPCLK2Freq))

[Called By]

- >> UART_SetConfig

HAL_RCC_GetSysClockFreq (Thumb, 58 bytes, Stack size 0 bytes, stm32f1xx_hal_rcc.o(i.HAL_RCC_GetSysClockFreq))

[Called By]

- >> HAL_RCC_ClockConfig

HAL_RCC_OscConfig (Thumb, 778 bytes, Stack size 40 bytes, stm32f1xx_hal_rcc.o(i.HAL_RCC_OscConfig))

[Stack]

- Max Depth = 40
- Call Chain = HAL_RCC_OscConfig

[Calls]

- >> HAL_GetTick

[Called By]

- >> SystemClock_Config

HAL_SYSTICK_Config (Thumb, 40 bytes, Stack size 8 bytes, stm32f1xx_hal_cortex.o(i.HAL_SYSTICK_Config))

[Stack]

- Max Depth = 8
- Call Chain = HAL_SYSTICK_Config

[Calls]

- >> __NVIC_SetPriority

[Called By]

- >> HAL_InitTick

HAL_TIMEx_BreakCallback (Thumb, 2 bytes, Stack size 0 bytes, stm32f1xx_hal_tim_ex.o(i.HAL_TIMEx_BreakCallback))

[Called By]

- >> HAL_TIM_IRQHandler

HAL_TIMEx_CommutCallback (Thumb, 2 bytes, Stack size 0 bytes, stm32f1xx_hal_tim_ex.o(i.HAL_TIMEx_CommutCallback))

[Called By]

- >> HAL_TIM_IRQHandler

HAL_TIMEx_MasterConfigSynchronization (Thumb, 92 bytes, Stack size 16 bytes, stm32f1xx_hal_tim_ex.o(i.HAL_TIMEx_MasterConfigSynchronization))

[Stack]

- Max Depth = 16
- Call Chain = HAL_TIMEx_MasterConfigSynchronization

[Called By]

- >> MX_TIM4_Init
- >> MX_TIM3_Init
- >> MX_TIM2_Init
- >> MX_TIM1_Init

HAL_TIM_Base_Init (Thumb, 90 bytes, Stack size 8 bytes, stm32f1xx_hal_tim.o(i.HAL_TIM_Base_Init))

[Stack]

- Max Depth = 32
- Call Chain = HAL_TIM_Base_Init ⇒ HAL_TIM_Base_MspInit ⇒ HAL_NVIC_SetPriority

[Calls]

- >> HAL_TIM_Base_MspInit
- >> TIM_Base_SetConfig

[Called By]

- >> MX_TIM3_Init

HAL_TIM_Base_MspInit (Thumb, 50 bytes, Stack size 8 bytes, stm32f1xx_hal_msp.o(i.HAL_TIM_Base_MspInit))

[Stack]

- Max Depth = 24
- Call Chain = HAL_TIM_Base_MspInit ⇒ HAL_NVIC_SetPriority

[Calls]

- >> HAL_NVIC_SetPriority
- >> HAL_NVIC_EnableIRQ

[Called By]

- >> HAL_TIM_Base_Init

HAL_TIM_Base_Start_IT (Thumb, 76 bytes, Stack size 0 bytes, stm32f1xx_hal_tim.o(i.HAL_TIM_Base_Start_IT))

[Called By]

- >> main

HAL_TIM_ConfigClockSource (Thumb, 220 bytes, Stack size 16 bytes, stm32f1xx_hal_tim.o(i.HAL_TIM_ConfigClockSource))

[Stack]

- Max Depth = 24
- Call Chain = HAL_TIM_ConfigClockSource ⇒ TIM_ETR_SetConfig

[Calls]

- >> TIM_ETR_SetConfig
- >> TIM_TI2_ConfigInputStage
- >> TIM_TI1_ConfigInputStage
- >> TIM_ITRx_SetConfig

[Called By]

- >> MX_TIM3_Init

HAL_TIM_Encoder_Init (Thumb, 164 bytes, Stack size 24 bytes, stm32f1xx_hal_tim.o(i.HAL_TIM_Encoder_Init))

[Stack]

- Max Depth = 88
- Call Chain = HAL_TIM_Encoder_Init ⇒ HAL_TIM_Encoder_MspInit ⇒ HAL_GPIO_Init

[Calls]

- >> HAL_TIM_Encoder_MspInit
- >> TIM_Base_SetConfig

[Called By]

- >> MX_TIM2_Init
- >> MX_TIM1_Init

HAL_TIM_Encoder_MspInit (Thumb, 122 bytes, Stack size 24 bytes, stm32f1xx_hal_msp.o(i.HAL_TIM_Encoder_MspInit))

[Stack]

- Max Depth = 64
- Call Chain = HAL_TIM_Encoder_MspInit ⇒ HAL_GPIO_Init

[Calls]

- >> HAL_GPIO_Init

[Called By]

- >> HAL_TIM_Encoder_Init

HAL_TIM_Encoder_Start (Thumb, 142 bytes, Stack size 16 bytes, stm32f1xx_hal_tim.o(i.HAL_TIM_Encoder_Start))

[Stack]

- Max Depth = 24
- Call Chain = HAL_TIM_Encoder_Start ⇒ TIM_CCxChannelCmd

[Calls]

- >> TIM_CCxChannelCmd

[Called By]

- >> main

HAL_TIM_IC_CaptureCallback (Thumb, 2 bytes, Stack size 0 bytes, stm32f1xx_hal_tim.o(i.HAL_TIM_IC_CaptureCallback))

[Called By]

- >> HAL_TIM_IRQHandler

HAL_TIM_IRQHandler (Thumb, 358 bytes, Stack size 16 bytes, stm32f1xx_hal_tim.o(i.HAL_TIM_IRQHandler))

[Stack]

- Max Depth = 160
- Call Chain = HAL_TIM_IRQHandler ⇒ HAL_TIM_PeriodElapsedCallback ⇒ PIControllerR ⇒ __aeabi_dmul

[Calls]

- >> HAL_TIM_PeriodElapsedCallback
- >> HAL_TIM_TriggerCallback
- >> HAL_TIM_PWM_PulseFinishedCallback
- >> HAL_TIM_OC_DelayElapsedCallback
- >> HAL_TIM_IC_CaptureCallback
- >> HAL_TIMEx_CommutCallback
- >> HAL_TIMEx_BreakCallback

[Called By]

- >> TIM3_IRQHandler

HAL_TIM_MspPostInit (Thumb, 64 bytes, Stack size 24 bytes, stm32f1xx_hal_msp.o(i.HAL_TIM_MspPostInit))

[Stack]

- Max Depth = 64
- Call Chain = HAL_TIM_MspPostInit ⇒ HAL_GPIO_Init

[Calls]

- >> HAL_GPIO_Init

[Called By]

- >> MX_TIM4_Init

HAL_TIM_OC_DelayElapsedCallback (Thumb, 2 bytes, Stack size 0 bytes, stm32f1xx_hal_tim.o(i.HAL_TIM_OC_DelayElapsedCallback))

[Called By]

- >> HAL_TIM_IRQHandler

HAL_TIM_PWM_ConfigChannel (Thumb, 204 bytes, Stack size 16 bytes, stm32f1xx_hal_tim.o(i.HAL_TIM_PWM_ConfigChannel))

[Stack]

- Max Depth = 28
- Call Chain = HAL_TIM_PWM_ConfigChannel ⇒ TIM_OC2_SetConfig

[Calls]

- >> TIM_OC2_SetConfig
- >> TIM_OC4_SetConfig
- >> TIM_OC3_SetConfig
- >> TIM_OC1_SetConfig

[Called By]

- >> MX_TIM4_Init

HAL_TIM_PWM_Init (Thumb, 90 bytes, Stack size 8 bytes, stm32f1xx_hal_tim.o(i.HAL_TIM_PWM_Init))

[Stack]

- Max Depth = 28
- Call Chain = HAL_TIM_PWM_Init ⇒ TIM_Base_SetConfig

[Calls]

- >> HAL_TIM_PWM_MspInit
- >> TIM_Base_SetConfig

[Called By]

- >> MX_TIM4_Init

HAL_TIM_PWM_MspInit (Thumb, 30 bytes, Stack size 8 bytes, stm32f1xx_hal_msp.o(i.HAL_TIM_PWM_MspInit))

[Stack]

- Max Depth = 8
- Call Chain = HAL_TIM_PWM_MspInit

[Called By]

- >> HAL_TIM_PWM_Init

HAL_TIM_PWM_PulseFinishedCallback (Thumb, 2 bytes, Stack size 0 bytes, stm32f1xx_hal_tim.o(i.HAL_TIM_PWM_PulseFinishedCallback))

[Called By]

- >> HAL_TIM_IRQHandler

HAL_TIM_PWM_Start (Thumb, 144 bytes, Stack size 8 bytes, stm32f1xx_hal_tim.o(i.HAL_TIM_PWM_Start))

[Stack]

- Max Depth = 16
- Call Chain = HAL_TIM_PWM_Start ⇒ TIM_CCxChannelCmd

[Calls]

- >> TIM_CCxChannelCmd

[Called By]

- >> main

HAL_TIM_PeriodElapsedCallback (Thumb, 336 bytes, Stack size 48 bytes, main.o(i.HAL_TIM_PeriodElapsedCallback))

[Stack]

- Max Depth = 144
- Call Chain = HAL_TIM_PeriodElapsedCallback ⇒ PIControllerR ⇒ __aeabi_dmul

[Calls]

- >> PIControllerR
- >> PIControllerL
- >> MotorRightRot
- >> MotorLeftRot
- >> __aeabi_dmul
- >> __aeabi_i2d
- >> __aeabi_d2iz
- >> __aeabi_ddiv
- >> __aeabi_d2f

[Called By]

- >> HAL_TIM_IRQHandler

HAL_TIM_TriggerCallback (Thumb, 2 bytes, Stack size 0 bytes, stm32f1xx_hal_tim.o(i.HAL_TIM_TriggerCallback))

[Called By]

- >> HAL_TIM_IRQHandler

HAL_UARTEx_RxEventCallback (Thumb, 2 bytes, Stack size 0 bytes, stm32f1xx_hal_uart.o(i.HAL_UARTEx_RxEventCallback))

[Called By]

- >> HAL_UART_IRQHandler
- >> UART_Receive_IT

HAL_UART_ErrorCallback (Thumb, 2 bytes, Stack size 0 bytes, stm32f1xx_hal_uart.o(i.HAL_UART_ErrorCallback))

[Called By]

- >> HAL_UART_IRQHandler
- >> UART_DMAAbortOnError

HAL_UART_IRQHandler (Thumb, 616 bytes, Stack size 24 bytes, stm32f1xx_hal_uart.o(i.HAL_UART_IRQHandler))

[Stack]

- Max Depth = 40
- Call Chain = HAL_UART_IRQHandler ⇒ UART_Receive_IT ⇒ HAL_UART_RxCpltCallback

[Calls]

- >> HAL_DMA_Abort_IT
- >> HAL_DMA_Abort
- >> HAL_UART_TxCpltCallback
- >> HAL_UART_ErrorCallback
- >> HAL_UARTEx_RxEventCallback
- >> UART_Receive_IT
- >> UART_EndRxTransfer

[Called By]

- >> USART3_IRQHandler

HAL_UART_Init (Thumb, 100 bytes, Stack size 16 bytes, stm32f1xx_hal_uart.o(i.HAL_UART_Init))

[Stack]

- Max Depth = 88
- Call Chain = HAL_UART_Init ⇒ HAL_UART_MspInit ⇒ HAL_GPIO_Init

[Calls]

- >> HAL_UART_MspInit
- >> UART_SetConfig

[Called By]

- >> main

HAL_UART_MspInit (Thumb, 116 bytes, Stack size 32 bytes, stm32f1xx_hal_msp.o(i.HAL_UART_MspInit))

[Stack]

- Max Depth = 72
- Call Chain = HAL_UART_MspInit ⇒ HAL_GPIO_Init

[Calls]

- >> HAL_NVIC_SetPriority
- >> HAL_NVIC_EnableIRQ
- >> HAL_GPIO_Init

[Called By]

- >> HAL_UART_Init

HAL_UART_Receive_IT (Thumb, 28 bytes, Stack size 0 bytes, stm32f1xx_hal_uart.o(i.HAL_UART_Receive_IT))

[Calls]

- >> UART_Start_Receive_IT

[Called By]

- >> main
- >> HAL_UART_RxCpltCallback

HAL_UART_RxCpltCallback (Thumb, 90 bytes, Stack size 8 bytes, main.o(i.HAL_UART_RxCpltCallback))

[Stack]

- Max Depth = 8
- Call Chain = HAL_UART_RxCpltCallback

[Calls]

- >> HAL_UART_Receive_IT

[Called By]

- >> UART_Receive_IT

HAL_UART_TxCpltCallback (Thumb, 2 bytes, Stack size 0 bytes, stm32f1xx_hal_uart.o(i.HAL_UART_TxCpltCallback))

[Called By]

- >> HAL_UART_IRQHandler

HardFault_Handler (Thumb, 2 bytes, Stack size 0 bytes, stm32f1xx_it.o(i.HardFault_Handler))

[Calls]

- >> HardFault_Handler

[Called By]

- >> HardFault_Handler

[Address Reference Count : 1]

- startup_stm32f103xb.o(RESET)

MX_USB_DEVICE_Init (Thumb, 66 bytes, Stack size 8 bytes, usb_device.o(i.MX_USB_DEVICE_Init))

[Stack]

- Max Depth = 96
- Call Chain = MX_USB_DEVICE_Init ⇒ USBD_Init ⇒ USBD_LL_Init ⇒ HAL_PCD_Init ⇒ HAL_PCD_MspInit ⇒ HAL_NVIC_SetPriority

[Calls]

- >> USBD_Start
- >> USBD_RegisterClass
- >> USBD_Init
- >> USBD_CDC_RegisterInterface
- >> Error_Handler

[Called By]

- >> main

MemManage_Handler (Thumb, 2 bytes, Stack size 0 bytes, stm32f1xx_it.o(i.MemManage_Handler))

[Calls]

- >> MemManage_Handler

[Called By]

- >> MemManage_Handler

[Address Reference Count : 1]

- startup_stm32f103xb.o(RESET)

MotorLeftRot (Thumb, 84 bytes, Stack size 16 bytes, main.o(i.MotorLeftRot))

[Stack]

- Max Depth = 16
- Call Chain = MotorLeftRot

[Calls]

- >> HAL_GPIO_WritePin

[Called By]

- >> main
- >> HAL_TIM_PeriodElapsedCallback

MotorRightRot (Thumb, 84 bytes, Stack size 16 bytes, main.o(i.MotorRightRot))

[Stack]

- Max Depth = 16
- Call Chain = MotorRightRot

[Calls]

- >> HAL_GPIO_WritePin

[Called By]

- >> main
- >> HAL_TIM_PeriodElapsedCallback

NMI_Handler (Thumb, 2 bytes, Stack size 0 bytes, stm32f1xx_it.o(i.NMI_Handler))

[Calls]

- >> NMI_Handler

[Called By]

- >> NMI_Handler

[Address Reference Count : 1]

- startup_stm32f103xb.o(RESET)

PIControllerL (Thumb, 186 bytes, Stack size 64 bytes, main.o(i.PIControllerL))

[Stack]

- Max Depth = 96
- Call Chain = PIControllerL ⇒ __aeabi_dmul

[Calls]

- >> __aeabi_fmul
- >> __aeabi_i2f
- >> __aeabi_f2iz
- >> __aeabi_fsub
- >> __aeabi_fadd
- >> __aeabi_f2d
- >> __aeabi_dmul
- >> __aeabi_dadd
- >> __aeabi_d2f

[Called By]

- >> HAL_TIM_PeriodElapsedCallback

PIControllerR (Thumb, 186 bytes, Stack size 64 bytes, main.o(i.PIControllerR))

[Stack]

- Max Depth = 96
- Call Chain = PIControllerR ⇒ __aeabi_dmul

[Calls]

- >> __aeabi_fmul
- >> __aeabi_i2f
- >> __aeabi_f2iz
- >> __aeabi_fsub
- >> __aeabi_fadd
- >> __aeabi_f2d
- >> __aeabi_dmul
- >> __aeabi_dadd
- >> __aeabi_d2f

[Called By]

- >> HAL_TIM_PeriodElapsedCallback

PendSV_Handler (Thumb, 2 bytes, Stack size 0 bytes, stm32f1xx_it.o(i.PendSV_Handler))
[Address Reference Count : 1]

- startup_stm32f103xb.o(RESET)

SVC_Handler (Thumb, 2 bytes, Stack size 0 bytes, stm32f1xx_it.o(i.SVC_Handler))
[Address Reference Count : 1]

- startup_stm32f103xb.o(RESET)

SysTick_Handler (Thumb, 4 bytes, Stack size 0 bytes, stm32f1xx_it.o(i.SysTick_Handler))

[Calls]

- >> HAL_IncTick

[Address Reference Count : 1]

- startup_stm32f103xb.o(RESET)

SystemClock_Config (Thumb, 118 bytes, Stack size 88 bytes, main.o(i.SystemClock_Config))

[Stack]

- Max Depth = 152
- Call Chain = SystemClock_Config ⇒ HAL_RCC_ClockConfig ⇒ HAL_InitTick ⇒ HAL_NVIC_SetPriority

[Calls]

- >> HAL_RCC_OscConfig
- >> HAL_RCC_ClockConfig
- >> HAL_RCCEx_PeriphCLKConfig
- >> __aeabi_memclr4

[Called By]

- >> main

SystemInit (Thumb, 2 bytes, Stack size 0 bytes, system_stm32f1xx.o(i.SystemInit))
[Address Reference Count : 1]

- startup_stm32f103xb.o(.text)

TIM3_IRQHandler (Thumb, 6 bytes, Stack size 0 bytes, stm32f1xx_it.o(i.TIM3_IRQHandler))

[Stack]

- Max Depth = 160
- Call Chain = TIM3_IRQHandler ⇒ HAL_TIM_IRQHandler ⇒ HAL_TIM_PeriodElapsedCallback ⇒ PIControllerR ⇒ __aeabi_dmul

[Calls]

- >> HAL_TIM_IRQHandler

[Address Reference Count : 1]

- startup_stm32f103xb.o(RESET)

TIM_Base_SetConfig (Thumb, 94 bytes, Stack size 20 bytes, stm32f1xx_hal_tim.o(i.TIM_Base_SetConfig))

[Stack]

- Max Depth = 20
- Call Chain = TIM_Base_SetConfig

[Called By]

- >> HAL_TIM_PWM_Init
- >> HAL_TIM_Encoder_Init
- >> HAL_TIM_Base_Init

TIM_CCxChannelCmd (Thumb, 26 bytes, Stack size 8 bytes, stm32f1xx_hal_tim.o(i.TIM_CCxChannelCmd))

[Stack]

- Max Depth = 8
- Call Chain = TIM_CCxChannelCmd

[Called By]

- >> HAL_TIM_PWM_Start
- >> HAL_TIM_Encoder_Start

TIM_ETR_SetConfig (Thumb, 20 bytes, Stack size 8 bytes, stm32f1xx_hal_tim.o(i.TIM_ETR_SetConfig))

[Stack]

- Max Depth = 8
- Call Chain = TIM_ETR_SetConfig

[Called By]

- >> HAL_TIM_ConfigClockSource

TIM_OC2_SetConfig (Thumb, 84 bytes, Stack size 12 bytes, stm32f1xx_hal_tim.o(i.TIM_OC2_SetConfig))

[Stack]

- Max Depth = 12
- Call Chain = TIM_OC2_SetConfig

[Called By]

- >> HAL_TIM_PWM_ConfigChannel

UART_Start_Receive_IT (Thumb, 54 bytes, Stack size 0 bytes, stm32f1xx_hal_uart.o(i.UART_Start_Receive_IT))

[Called By]

- >> HAL_UART_Receive_IT

USART3_IRQHandler (Thumb, 6 bytes, Stack size 0 bytes, stm32f1xx_it.o(i.USART3_IRQHandler))

[Stack]

- Max Depth = 40
- Call Chain = USART3_IRQHandler ⇒ HAL_UART_IRQHandler ⇒ UART_Receive_IT ⇒ HAL_UART_RxCpltCallback

[Calls]

- >> HAL_UART_IRQHandler

[Address Reference Count : 1]

- startup_stm32f103xb.o(RESET)

USBD_CDC_GetDeviceQualifierDescriptor (Thumb, 8 bytes, Stack size 0 bytes, usbd_cdc.o(i.USBD_CDC_GetDeviceQualifierDescriptor))
[Address Reference Count : 1]

- usbd_cdc.o(.data)

USBD_CDC_ReceivePacket (Thumb, 40 bytes, Stack size 8 bytes, usbd_cdc.o(i.USBD_CDC_ReceivePacket))

[Stack]

- Max Depth = 64
- Call Chain = USBD_CDC_ReceivePacket ⇒ USBD_LL_PrepareReceive ⇒ HAL_PCD_EP_Receive ⇒ USB_EPStartXfer ⇒ USB_WritePMA

[Calls]

- >> USBD_LL_PrepareReceive

[Called By]

- >> CDC_Receive_FS

USBD_CDC_RegisterInterface (Thumb, 16 bytes, Stack size 0 bytes, usbd_cdc.o(i.USBD_CDC_RegisterInterface))

[Called By]

- >> MX_USB_DEVICE_Init

USBD_CDC_SetRxBuffer (Thumb, 12 bytes, Stack size 0 bytes, usbd_cdc.o(i.USBD_CDC_SetRxBuffer))

[Called By]

- >> CDC_Receive_FS
- >> CDC_Init_FS

USBD_CDC_SetTxBuffer (Thumb, 16 bytes, Stack size 0 bytes, usbd_cdc.o(i.USBD_CDC_SetTxBuffer))

[Called By]

- >> CDC_Init_FS

USBD_ClrClassConfig (Thumb, 14 bytes, Stack size 8 bytes, usbd_core.o(i.USBD_ClrClassConfig))

[Stack]

- Max Depth = 8
- Call Chain = USBD_ClrClassConfig

[Called By]

- >> USBD_SetConfig

USBD_CtlContinueRx (Thumb, 16 bytes, Stack size 8 bytes, usbd_ioreq.o(i.USBD_CtlContinueRx))

[Stack]

- Max Depth = 64
- Call Chain = USBD_CtlContinueRx ⇒ USBD_LL_PrepareReceive ⇒ HAL_PCD_EP_Receive ⇒ USB_EPStartXfer ⇒ USB_WritePMA

[Calls]

- >> USBD_LL_PrepareReceive

[Called By]

- >> USBD_LL_DataOutStage

USBD_CtlContinueSendData (Thumb, 16 bytes, Stack size 8 bytes, usbd_ioreq.o(i.USBD_CtlContinueSendData))

[Stack]

- Max Depth = 64
- Call Chain = USBD_CtlContinueSendData ⇒ USBD_LL_Transmit ⇒ HAL_PCD_EP_Transmit ⇒ USB_EPStartXfer ⇒ USB_WritePMA

[Calls]

- >> USBD_LL_Transmit

[Called By]

- >> USBD_LL_DataInStage

USBD_CtlError (Thumb, 22 bytes, Stack size 8 bytes, usbd_ctlreq.o(i.USBD_CtlError))

[Stack]

- Max Depth = 40
- Call Chain = USBD_CtlError ⇒ USBD_LL_StallEP ⇒ HAL_PCD_EP_SetStall ⇒ USB_EPSetStall

[Calls]

- >> USBD_LL_StallEP

[Called By]

- >> USBD_SetConfig
- >> USBD_GetDescriptor
- >> USBD_StdItfReq
- >> USBD_StdEPReq
- >> USBD_StdDevReq
- >> USBD_CDC_Setup

USBD_CtlPrepareRx (Thumb, 30 bytes, Stack size 8 bytes, usbd_ioreq.o(i.USBD_CtlPrepareRx))

[Stack]

- Max Depth = 64
- Call Chain = USBD_CtlPrepareRx ⇒ USBD_LL_PrepareReceive ⇒ HAL_PCD_EP_Receive ⇒ USB_EPStartXfer ⇒ USB_WritePMA

[Calls]

- >> USBD_LL_PrepareReceive

[Called By]

- >> USBD_CDC_Setup

USBD_CtlReceiveStatus (Thumb, 22 bytes, Stack size 8 bytes, usbd_ioreq.o(i.USBD_CtlReceiveStatus))

[Stack]

- Max Depth = 64
- Call Chain = USBD_CtlReceiveStatus ⇒ USBD_LL_PrepareReceive ⇒ HAL_PCD_EP_Receive ⇒ USB_EPStartXfer ⇒ USB_WritePMA

[Calls]

- >> USBD_LL_PrepareReceive

[Called By]

- >> USBD_LL_DataInStage

USBD_CtlSendData (Thumb, 26 bytes, Stack size 8 bytes, usbd_ioreq.o(i.USBD_CtlSendData))

[Stack]

- Max Depth = 64
- Call Chain = USBD_CtlSendData ⇒ USBD_LL_Transmit ⇒ HAL_PCD_EP_Transmit ⇒ USB_EPStartXfer ⇒ USB_WritePMA

[Calls]

- >> USBD_LL_Transmit

[Called By]

- >> USBD_GetDescriptor
- >> USBD_StdEPReq
- >> USBD_StdDevReq
- >> USBD_CDC_Setup

USBD_CtlSendStatus (Thumb, 22 bytes, Stack size 8 bytes, usbd_ioreq.o(i.USBD_CtlSendStatus))

[Stack]

- Max Depth = 64
- Call Chain = USBD_CtlSendStatus ⇒ USBD_LL_Transmit ⇒ HAL_PCD_EP_Transmit ⇒ USB_EPStartXfer ⇒ USB_WritePMA

[Calls]

- >> USBD_LL_Transmit

[Called By]

- >> USBD_LL_DataOutStage
- >> USBD_SetConfig
- >> USBD_GetDescriptor
- >> USBD_StdItfReq
- >> USBD_StdEPReq
- >> USBD_StdDevReq

USBD_FS_ConfigStrDescriptor (Thumb, 16 bytes, Stack size 8 bytes, usbd_desc.o(i.USBD_FS_ConfigStrDescriptor))

[Stack]

- Max Depth = 24
- Call Chain = USBD_FS_ConfigStrDescriptor ⇒ USBD_GetString

[Calls]

- >> USBD_GetString

[Address Reference Count : 1]

- usbd_desc.o(.data)

USBD_FS_DeviceDescriptor (Thumb, 8 bytes, Stack size 0 bytes, usbd_desc.o(i.USBD_FS_DeviceDescriptor))
[Address Reference Count : 1]

- usbd_desc.o(.data)

USBD_FS_InterfaceStrDescriptor (Thumb, 16 bytes, Stack size 8 bytes, usbd_desc.o(i.USBD_FS_InterfaceStrDescriptor))

[Stack]

- Max Depth = 24
- Call Chain = USBD_FS_InterfaceStrDescriptor ⇒ USBD_GetString

[Calls]

- >> USBD_GetString

[Address Reference Count : 1]

- usbd_desc.o(.data)

USBD_FS_LangIDStrDescriptor (Thumb, 8 bytes, Stack size 0 bytes, usbd_desc.o(i.USBD_FS_LangIDStrDescriptor))
[Address Reference Count : 1]

- usbd_desc.o(.data)

USBD_FS_ManufacturerStrDescriptor (Thumb, 16 bytes, Stack size 8 bytes, usbd_desc.o(i.USBD_FS_ManufacturerStrDescriptor))

[Stack]

- Max Depth = 24
- Call Chain = USBD_FS_ManufacturerStrDescriptor ⇒ USBD_GetString

[Calls]

- >> USBD_GetString

[Address Reference Count : 1]

- usbd_desc.o(.data)

USBD_FS_ProductStrDescriptor (Thumb, 16 bytes, Stack size 8 bytes, usbd_desc.o(i.USBD_FS_ProductStrDescriptor))

[Stack]

- Max Depth = 24
- Call Chain = USBD_FS_ProductStrDescriptor ⇒ USBD_GetString

[Calls]

- >> USBD_GetString

[Address Reference Count : 1]

- usbd_desc.o(.data)

USBD_FS_SerialStrDescriptor (Thumb, 48 bytes, Stack size 8 bytes, usbd_desc.o(i.USBD_FS_SerialStrDescriptor))

[Stack]

- Max Depth = 28
- Call Chain = USBD_FS_SerialStrDescriptor ⇒ IntToUnicode

[Calls]

- >> IntToUnicode

[Address Reference Count : 1]

- usbd_desc.o(.data)

USBD_GetString (Thumb, 72 bytes, Stack size 16 bytes, usbd_ctlreq.o(i.USBD_GetString))

[Stack]

- Max Depth = 16
- Call Chain = USBD_GetString

[Called By]

- >> USBD_FS_ProductStrDescriptor
- >> USBD_FS_ManufacturerStrDescriptor
- >> USBD_FS_InterfaceStrDescriptor
- >> USBD_FS_ConfigStrDescriptor

USBD_Init (Thumb, 42 bytes, Stack size 8 bytes, usbd_core.o(i.USBD_Init))

[Stack]

- Max Depth = 88
- Call Chain = USBD_Init ⇒ USBD_LL_Init ⇒ HAL_PCD_Init ⇒ HAL_PCD_MspInit ⇒ HAL_NVIC_SetPriority

[Calls]

- >> USBD_LL_Init

[Called By]

- >> MX_USB_DEVICE_Init

USBD_LL_ClearStallEP (Thumb, 18 bytes, Stack size 8 bytes, usbd_conf.o(i.USBD_LL_ClearStallEP))

[Stack]

- Max Depth = 36
- Call Chain = USBD_LL_ClearStallEP ⇒ HAL_PCD_EP_ClrStall ⇒ USB_EPClearStall

[Calls]

- >> HAL_PCD_EP_ClrStall
- >> USBD_Get_USB_Status

[Called By]

- >> USBD_StdEPReq

USBD_LL_CloseEP (Thumb, 18 bytes, Stack size 8 bytes, usbd_conf.o(i.USBD_LL_CloseEP))

[Stack]

- Max Depth = 52
- Call Chain = USBD_LL_CloseEP ⇒ HAL_PCD_EP_Close ⇒ USB_DeactivateEndpoint

[Calls]

- >> HAL_PCD_EP_Close
- >> USBD_Get_USB_Status

[Called By]

- >> USBD_CDC_DeInit

USBD_LL_DataInStage (Thumb, 198 bytes, Stack size 24 bytes, usbd_core.o(i.USBD_LL_DataInStage))

[Stack]

- Max Depth = 88
- Call Chain = USBD_LL_DataInStage ⇒ USBD_CtlReceiveStatus ⇒ USBD_LL_PrepareReceive ⇒ HAL_PCD_EP_Receive ⇒ USB_EPStartXfer ⇒ USB_WritePMA

[Calls]

- >> USBD_LL_StallEP
- >> USBD_LL_PrepareReceive
- >> USBD_CtlReceiveStatus
- >> USBD_CtlContinueSendData

[Called By]

- >> HAL_PCD_DataInStageCallback

USBD_LL_DataOutStage (Thumb, 130 bytes, Stack size 16 bytes, usbd_core.o(i.USBD_LL_DataOutStage))

[Stack]

- Max Depth = 80
- Call Chain = USBD_LL_DataOutStage ⇒ USBD_CtlSendStatus ⇒ USBD_LL_Transmit ⇒ HAL_PCD_EP_Transmit ⇒ USB_EPStartXfer ⇒ USB_WritePMA

[Calls]

- >> USBD_LL_StallEP
- >> USBD_CtlSendStatus
- >> USBD_CtlContinueRx

[Called By]

- >> HAL_PCD_DataOutStageCallback

USBD_LL_GetRxDataSize (Thumb, 8 bytes, Stack size 0 bytes, usbd_conf.o(i.USBD_LL_GetRxDataSize))

[Calls]

- >> HAL_PCD_EP_GetRxCount

[Called By]

- >> USBD_CDC_DataOut

USBD_LL_Init (Thumb, 118 bytes, Stack size 8 bytes, usbd_conf.o(i.USBD_LL_Init))

[Stack]

- Max Depth = 80
- Call Chain = USBD_LL_Init ⇒ HAL_PCD_Init ⇒ HAL_PCD_MspInit ⇒ HAL_NVIC_SetPriority

[Calls]

- >> Error_Handler
- >> HAL_PCD_Init
- >> HAL_PCDEx_PMAConfig

[Called By]

- >> USBD_Init

USBD_LL_IsStallEP (Thumb, 32 bytes, Stack size 0 bytes, usbd_conf.o(i.USBD_LL_IsStallEP))

[Called By]

- >> USBD_StdEPReq

USBD_LL_OpenEP (Thumb, 24 bytes, Stack size 8 bytes, usbd_conf.o(i.USBD_LL_OpenEP))

[Stack]

- Max Depth = 64
- Call Chain = USBD_LL_OpenEP ⇒ HAL_PCD_EP_Open ⇒ USB_ActivateEndpoint

[Calls]

- >> HAL_PCD_EP_Open
- >> USBD_Get_USB_Status

[Called By]

- >> USBD_LL_Reset
- >> USBD_CDC_Init

USBD_LL_PrepareReceive (Thumb, 18 bytes, Stack size 8 bytes, usbd_conf.o(i.USBD_LL_PrepareReceive))

[Stack]

- Max Depth = 56
- Call Chain = USBD_LL_PrepareReceive ⇒ HAL_PCD_EP_Receive ⇒ USB_EPStartXfer ⇒ USB_WritePMA

[Calls]

- >> HAL_PCD_EP_Receive
- >> USBD_Get_USB_Status

[Called By]

- >> USBD_LL_DataInStage
- >> USBD_CDC_ReceivePacket
- >> USBD_CtlPrepareRx
- >> USBD_CtlReceiveStatus
- >> USBD_CtlContinueRx
- >> USBD_CDC_Init

USBD_LL_Reset (Thumb, 80 bytes, Stack size 16 bytes, usbd_core.o(i.USBD_LL_Reset))

[Stack]

- Max Depth = 80
- Call Chain = USBD_LL_Reset ⇒ USBD_LL_OpenEP ⇒ HAL_PCD_EP_Open ⇒ USB_ActivateEndpoint

[Calls]

- >> USBD_LL_OpenEP

[Called By]

- >> HAL_PCD_ResetCallback

USBD_LL_Resume (Thumb, 20 bytes, Stack size 0 bytes, usbd_core.o(i.USBD_LL_Resume))

[Called By]

- >> HAL_PCD_ResumeCallback

USBD_LL_SOF (Thumb, 24 bytes, Stack size 8 bytes, usbd_core.o(i.USBD_LL_SOF))

[Stack]

- Max Depth = 8
- Call Chain = USBD_LL_SOF

[Called By]

- >> HAL_PCD_SOFCallback

USBD_LL_SetSpeed (Thumb, 6 bytes, Stack size 0 bytes, usbd_core.o(i.USBD_LL_SetSpeed))

[Called By]

- >> HAL_PCD_ResetCallback

USBD_LL_SetUSBAddress (Thumb, 18 bytes, Stack size 8 bytes, usbd_conf.o(i.USBD_LL_SetUSBAddress))

[Stack]

- Max Depth = 16
- Call Chain = USBD_LL_SetUSBAddress ⇒ HAL_PCD_SetAddress

[Calls]

- >> HAL_PCD_SetAddress
- >> USBD_Get_USB_Status

[Called By]

- >> USBD_StdDevReq

USBD_LL_SetupStage (Thumb, 90 bytes, Stack size 16 bytes, usbd_core.o(i.USBD_LL_SetupStage))

[Stack]

- Max Depth = 128
- Call Chain = USBD_LL_SetupStage ⇒ USBD_StdDevReq ⇒ USBD_GetDescriptor ⇒ USBD_CtlSendData ⇒ USBD_LL_Transmit ⇒ HAL_PCD_EP_Transmit ⇒ USB_EPStartXfer ⇒ USB_WritePMA

[Calls]

- >> USBD_LL_StallEP
- >> USBD_StdItfReq
- >> USBD_StdEPReq
- >> USBD_StdDevReq
- >> USBD_ParseSetupRequest

[Called By]

- >> HAL_PCD_SetupStageCallback

USBD_LL_StallEP (Thumb, 18 bytes, Stack size 8 bytes, usbd_conf.o(i.USBD_LL_StallEP))

[Stack]

- Max Depth = 32
- Call Chain = USBD_LL_StallEP ⇒ HAL_PCD_EP_SetStall ⇒ USB_EPSetStall

[Calls]

- >> HAL_PCD_EP_SetStall
- >> USBD_Get_USB_Status

[Called By]

- >> USBD_LL_SetupStage
- >> USBD_LL_DataOutStage
- >> USBD_LL_DataInStage
- >> USBD_CtlError
- >> USBD_StdEPReq

USBD_LL_Start (Thumb, 18 bytes, Stack size 8 bytes, usbd_conf.o(i.USBD_LL_Start))

[Stack]

- Max Depth = 16
- Call Chain = USBD_LL_Start ⇒ HAL_PCD_Start

[Calls]

- >> HAL_PCD_Start
- >> USBD_Get_USB_Status

[Called By]

- >> USBD_Start

USBD_LL_Suspend (Thumb, 18 bytes, Stack size 0 bytes, usbd_core.o(i.USBD_LL_Suspend))

[Called By]

- >> HAL_PCD_SuspendCallback

USBD_LL_Transmit (Thumb, 18 bytes, Stack size 8 bytes, usbd_conf.o(i.USBD_LL_Transmit))

[Stack]

- Max Depth = 56
- Call Chain = USBD_LL_Transmit ⇒ HAL_PCD_EP_Transmit ⇒ USB_EPStartXfer ⇒ USB_WritePMA

[Calls]

- >> HAL_PCD_EP_Transmit
- >> USBD_Get_USB_Status

[Called By]

- >> USBD_CtlSendData
- >> USBD_CtlSendStatus
- >> USBD_CtlContinueSendData
- >> USBD_CDC_DataIn

USBD_ParseSetupRequest (Thumb, 40 bytes, Stack size 0 bytes, usbd_ctlreq.o(i.USBD_ParseSetupRequest))

[Called By]

- >> USBD_LL_SetupStage

USBD_RegisterClass (Thumb, 16 bytes, Stack size 0 bytes, usbd_core.o(i.USBD_RegisterClass))

[Called By]

- >> MX_USB_DEVICE_Init

USBD_SetClassConfig (Thumb, 22 bytes, Stack size 8 bytes, usbd_core.o(i.USBD_SetClassConfig))

[Stack]

- Max Depth = 8
- Call Chain = USBD_SetClassConfig

[Called By]

- >> USBD_SetConfig

USBD_Start (Thumb, 10 bytes, Stack size 8 bytes, usbd_core.o(i.USBD_Start))

[Stack]

- Max Depth = 24
- Call Chain = USBD_Start ⇒ USBD_LL_Start ⇒ HAL_PCD_Start

[Calls]

- >> USBD_LL_Start

[Called By]

- >> MX_USB_DEVICE_Init

USBD_StdDevReq (Thumb, 274 bytes, Stack size 24 bytes, usbd_ctlreq.o(i.USBD_StdDevReq))

[Stack]

- Max Depth = 112
- Call Chain = USBD_StdDevReq ⇒ USBD_GetDescriptor ⇒ USBD_CtlSendData ⇒ USBD_LL_Transmit ⇒ HAL_PCD_EP_Transmit ⇒ USB_EPStartXfer ⇒ USB_WritePMA

[Calls]

- >> USBD_LL_SetUSBAddress
- >> USBD_CtlSendData
- >> USBD_CtlError
- >> USBD_SetConfig
- >> USBD_GetDescriptor
- >> USBD_CtlSendStatus

[Called By]

- >> USBD_LL_SetupStage

USBD_StdEPReq (Thumb, 336 bytes, Stack size 24 bytes, usbd_ctlreq.o(i.USBD_StdEPReq))

[Stack]

- Max Depth = 88
- Call Chain = USBD_StdEPReq ⇒ USBD_CtlSendData ⇒ USBD_LL_Transmit ⇒ HAL_PCD_EP_Transmit ⇒ USB_EPStartXfer ⇒ USB_WritePMA

[Calls]

- >> USBD_LL_StallEP
- >> USBD_LL_IsStallEP
- >> USBD_LL_ClearStallEP
- >> USBD_CtlSendData
- >> USBD_CtlError
- >> USBD_CtlSendStatus

[Called By]

- >> USBD_LL_SetupStage

USBD_StdItfReq (Thumb, 78 bytes, Stack size 16 bytes, usbd_ctlreq.o(i.USBD_StdItfReq))

[Stack]

- Max Depth = 80
- Call Chain = USBD_StdItfReq ⇒ USBD_CtlSendStatus ⇒ USBD_LL_Transmit ⇒ HAL_PCD_EP_Transmit ⇒ USB_EPStartXfer ⇒ USB_WritePMA

[Calls]

- >> USBD_CtlError
- >> USBD_CtlSendStatus

[Called By]

- >> USBD_LL_SetupStage

USBD_static_free (Thumb, 2 bytes, Stack size 0 bytes, usbd_conf.o(i.USBD_static_free))

[Called By]

- >> USBD_CDC_DeInit

USBD_static_malloc (Thumb, 4 bytes, Stack size 0 bytes, usbd_conf.o(i.USBD_static_malloc))

[Called By]

- >> USBD_CDC_Init

USB_ActivateEndpoint (Thumb, 668 bytes, Stack size 32 bytes, stm32f1xx_ll_usb.o(i.USB_ActivateEndpoint))

[Stack]

- Max Depth = 32
- Call Chain = USB_ActivateEndpoint

[Called By]

- >> HAL_PCD_EP_Open

USB_CoreInit (Thumb, 4 bytes, Stack size 0 bytes, stm32f1xx_ll_usb.o(i.USB_CoreInit))

[Called By]

- >> HAL_PCD_Init

USB_DeactivateEndpoint (Thumb, 270 bytes, Stack size 28 bytes, stm32f1xx_ll_usb.o(i.USB_DeactivateEndpoint))

[Stack]

- Max Depth = 28
- Call Chain = USB_DeactivateEndpoint

[Called By]

- >> HAL_PCD_EP_Close

USB_DevConnect (Thumb, 4 bytes, Stack size 0 bytes, stm32f1xx_ll_usb.o(i.USB_DevConnect))

[Called By]

- >> HAL_PCD_Start

USB_DevDisconnect (Thumb, 4 bytes, Stack size 0 bytes, stm32f1xx_ll_usb.o(i.USB_DevDisconnect))

[Called By]

- >> HAL_PCD_Init

USB_DevInit (Thumb, 18 bytes, Stack size 0 bytes, stm32f1xx_ll_usb.o(i.USB_DevInit))

[Called By]

- >> HAL_PCD_Init

USB_DisableGlobalInt (Thumb, 14 bytes, Stack size 0 bytes, stm32f1xx_ll_usb.o(i.USB_DisableGlobalInt))

[Called By]

- >> HAL_PCD_Init

USB_EP0_OutStart (Thumb, 4 bytes, Stack size 0 bytes, stm32f1xx_ll_usb.o(i.USB_EP0_OutStart))

[Called By]

- >> HAL_PCD_EP_SetStall

USB_EPClearStall (Thumb, 120 bytes, Stack size 12 bytes, stm32f1xx_ll_usb.o(i.USB_EPClearStall))

[Stack]

- Max Depth = 12
- Call Chain = USB_EPClearStall

[Called By]

- >> HAL_PCD_EP_ClrStall

USB_EPSetStall (Thumb, 50 bytes, Stack size 8 bytes, stm32f1xx_ll_usb.o(i.USB_EPSetStall))

[Stack]

- Max Depth = 8
- Call Chain = USB_EPSetStall

[Called By]

- >> HAL_PCD_EP_SetStall

USB_EPStartXfer (Thumb, 1250 bytes, Stack size 32 bytes, stm32f1xx_ll_usb.o(i.USB_EPStartXfer))

[Stack]

- Max Depth = 40
- Call Chain = USB_EPStartXfer ⇒ USB_WritePMA

[Calls]

- >> USB_WritePMA

[Called By]

- >> PCD_EP_ISR_Handler
- >> HAL_PCD_EP_Transmit
- >> HAL_PCD_EP_Receive

USB_EnableGlobalInt (Thumb, 18 bytes, Stack size 0 bytes, stm32f1xx_ll_usb.o(i.USB_EnableGlobalInt))

[Called By]

- >> HAL_PCD_Start

USB_LP_CAN1_RX0_IRQHandler (Thumb, 6 bytes, Stack size 0 bytes, stm32f1xx_it.o(i.USB_LP_CAN1_RX0_IRQHandler))

[Stack]

- Max Depth = 192
- Call Chain = USB_LP_CAN1_RX0_IRQHandler ⇒ HAL_PCD_IRQHandler ⇒ PCD_EP_ISR_Handler ⇒ HAL_PCD_EP_DB_Transmit ⇒ HAL_PCD_DataInStageCallback ⇒ USBD_LL_DataInStage ⇒ USBD_CtlReceiveStatus ⇒ USBD_LL_PrepareReceive ⇒ HAL_PCD_EP_Receive ⇒ USB_EPStartXfer ⇒ USB_WritePMA

[Calls]

- >> HAL_PCD_IRQHandler

[Address Reference Count : 1]

- startup_stm32f103xb.o(RESET)

USB_ReadInterrupts (Thumb, 6 bytes, Stack size 0 bytes, stm32f1xx_ll_usb.o(i.USB_ReadInterrupts))

[Called By]

- >> HAL_PCD_IRQHandler

USB_ReadPMA (Thumb, 44 bytes, Stack size 8 bytes, stm32f1xx_ll_usb.o(i.USB_ReadPMA))

[Stack]

- Max Depth = 8
- Call Chain = USB_ReadPMA

[Called By]

- >> PCD_EP_ISR_Handler
- >> HAL_PCD_EP_DB_Receive

USB_SetCurrentMode (Thumb, 4 bytes, Stack size 0 bytes, stm32f1xx_ll_usb.o(i.USB_SetCurrentMode))

[Called By]

- >> HAL_PCD_Init

USB_SetDevAddress (Thumb, 12 bytes, Stack size 0 bytes, stm32f1xx_ll_usb.o(i.USB_SetDevAddress))

[Called By]

- >> HAL_PCD_SetAddress

USB_WritePMA (Thumb, 38 bytes, Stack size 8 bytes, stm32f1xx_ll_usb.o(i.USB_WritePMA))

[Stack]

- Max Depth = 8
- Call Chain = USB_WritePMA

[Called By]

- >> USB_EPStartXfer
- >> HAL_PCD_EP_DB_Transmit

UsageFault_Handler (Thumb, 2 bytes, Stack size 0 bytes, stm32f1xx_it.o(i.UsageFault_Handler))

[Calls]

- >> UsageFault_Handler

[Called By]

- >> UsageFault_Handler

[Address Reference Count : 1]

- startup_stm32f103xb.o(RESET)

main (Thumb, 182 bytes, Stack size 0 bytes, main.o(i.main))

[Stack]

- Max Depth = 152
- Call Chain = main ⇒ SystemClock_Config ⇒ HAL_RCC_ClockConfig ⇒ HAL_InitTick ⇒ HAL_NVIC_SetPriority

[Calls]

- >> MX_USB_DEVICE_Init
- >> HAL_UART_Receive_IT
- >> HAL_UART_Init
- >> HAL_TIM_PWM_Start
- >> HAL_TIM_Encoder_Start
- >> HAL_TIM_Base_Start_IT
- >> HAL_Init
- >> SystemClock_Config
- >> MotorRightRot
- >> MotorLeftRot
- >> MX_TIM4_Init
- >> MX_TIM3_Init
- >> MX_TIM2_Init
- >> MX_TIM1_Init
- >> MX_GPIO_Init

[Called By]

- >> __rt_entry_main

__aeabi_d2f (Thumb, 0 bytes, Stack size 32 bytes, d2f.o(x$fpl$d2f))

[Stack]

- Max Depth = 32
- Call Chain = __aeabi_d2f

[Called By]

- >> PIControllerR
- >> PIControllerL
- >> HAL_TIM_PeriodElapsedCallback

_d2f (Thumb, 98 bytes, Stack size 32 bytes, d2f.o(x$fpl$d2f), UNUSED)

[Calls]

- >> __fpl_fretinf
- >> __fpl_dnaninf

__aeabi_dadd (Thumb, 0 bytes, Stack size 16 bytes, daddsub_clz.o(x$fpl$dadd))

[Stack]

- Max Depth = 16
- Call Chain = __aeabi_dadd

[Called By]

- >> PIControllerR
- >> PIControllerL

_dadd (Thumb, 332 bytes, Stack size 16 bytes, daddsub_clz.o(x$fpl$dadd), UNUSED)

[Calls]

- >> __fpl_dretinf
- >> __fpl_dnaninf
- >> _dsub1

__aeabi_ddiv (Thumb, 0 bytes, Stack size 32 bytes, ddiv.o(x$fpl$ddiv))

[Stack]

- Max Depth = 32
- Call Chain = __aeabi_ddiv

[Called By]

- >> HAL_TIM_PeriodElapsedCallback

_ddiv (Thumb, 552 bytes, Stack size 32 bytes, ddiv.o(x$fpl$ddiv), UNUSED)

[Calls]

- >> __fpl_dretinf
- >> __fpl_dnaninf

__aeabi_d2iz (Thumb, 0 bytes, Stack size 32 bytes, dfix.o(x$fpl$dfix))

[Stack]

- Max Depth = 32
- Call Chain = __aeabi_d2iz

[Called By]

- >> HAL_TIM_PeriodElapsedCallback

_dfix (Thumb, 94 bytes, Stack size 32 bytes, dfix.o(x$fpl$dfix), UNUSED)

[Calls]

- >> __fpl_dnaninf

__aeabi_i2d (Thumb, 0 bytes, Stack size 0 bytes, dflt_clz.o(x$fpl$dflt))

[Called By]

- >> HAL_TIM_PeriodElapsedCallback

_dflt (Thumb, 46 bytes, Stack size 0 bytes, dflt_clz.o(x$fpl$dflt), UNUSED)

__aeabi_dmul (Thumb, 0 bytes, Stack size 32 bytes, dmul.o(x$fpl$dmul))

[Stack]

- Max Depth = 32
- Call Chain = __aeabi_dmul

[Called By]

- >> PIControllerR
- >> PIControllerL
- >> HAL_TIM_PeriodElapsedCallback

_dmul (Thumb, 332 bytes, Stack size 32 bytes, dmul.o(x$fpl$dmul), UNUSED)

[Calls]

- >> __fpl_dretinf
- >> __fpl_dnaninf

__fpl_dnaninf (Thumb, 156 bytes, Stack size 16 bytes, dnaninf.o(x$fpl$dnaninf), UNUSED)

[Called By]

- >> _dmul
- >> _dfix
- >> _ddiv
- >> _dsub
- >> _dadd
- >> _d2f

__fpl_dretinf (Thumb, 12 bytes, Stack size 0 bytes, dretinf.o(x$fpl$dretinf), UNUSED)

[Called By]

- >> _f2d
- >> _dmul
- >> _ddiv
- >> _dadd

__aeabi_dsub (Thumb, 0 bytes, Stack size 32 bytes, daddsub_clz.o(x$fpl$dsub), UNUSED)

_dsub (Thumb, 464 bytes, Stack size 32 bytes, daddsub_clz.o(x$fpl$dsub), UNUSED)

[Calls]

- >> __fpl_dnaninf
- >> _dadd1

__aeabi_f2d (Thumb, 0 bytes, Stack size 16 bytes, f2d.o(x$fpl$f2d))

[Stack]

- Max Depth = 16
- Call Chain = __aeabi_f2d

[Called By]

- >> PIControllerR
- >> PIControllerL

_f2d (Thumb, 86 bytes, Stack size 16 bytes, f2d.o(x$fpl$f2d), UNUSED)

[Calls]

- >> __fpl_fnaninf
- >> __fpl_dretinf

__aeabi_fadd (Thumb, 0 bytes, Stack size 16 bytes, faddsub_clz.o(x$fpl$fadd))

[Stack]

- Max Depth = 16
- Call Chain = __aeabi_fadd

[Called By]

- >> PIControllerR
- >> PIControllerL

_fadd (Thumb, 196 bytes, Stack size 16 bytes, faddsub_clz.o(x$fpl$fadd), UNUSED)

[Calls]

- >> __fpl_fretinf
- >> __fpl_fnaninf
- >> _fsub1

__aeabi_f2iz (Thumb, 0 bytes, Stack size 16 bytes, ffix.o(x$fpl$ffix))

[Stack]

- Max Depth = 16
- Call Chain = __aeabi_f2iz

[Called By]

- >> PIControllerR
- >> PIControllerL

_ffix (Thumb, 54 bytes, Stack size 16 bytes, ffix.o(x$fpl$ffix), UNUSED)

[Calls]

- >> __fpl_fnaninf

__aeabi_i2f (Thumb, 0 bytes, Stack size 0 bytes, fflt_clz.o(x$fpl$fflt))

[Called By]

- >> PIControllerR
- >> PIControllerL

_fflt (Thumb, 48 bytes, Stack size 0 bytes, fflt_clz.o(x$fpl$fflt), UNUSED)

__aeabi_fmul (Thumb, 0 bytes, Stack size 16 bytes, fmul.o(x$fpl$fmul))

[Stack]

- Max Depth = 16
- Call Chain = __aeabi_fmul

[Called By]

- >> PIControllerR
- >> PIControllerL

_fmul (Thumb, 258 bytes, Stack size 16 bytes, fmul.o(x$fpl$fmul), UNUSED)

[Calls]

- >> __fpl_fretinf
- >> __fpl_fnaninf

__fpl_fnaninf (Thumb, 140 bytes, Stack size 8 bytes, fnaninf.o(x$fpl$fnaninf), UNUSED)

[Called By]

- >> _fmul
- >> _ffix
- >> _fsub
- >> _fadd
- >> _f2d

__fpl_fretinf (Thumb, 10 bytes, Stack size 0 bytes, fretinf.o(x$fpl$fretinf), UNUSED)

[Called By]

- >> _fmul
- >> _fadd
- >> _d2f

__aeabi_fsub (Thumb, 0 bytes, Stack size 16 bytes, faddsub_clz.o(x$fpl$fsub))

[Stack]

- Max Depth = 16
- Call Chain = __aeabi_fsub

[Called By]

- >> PIControllerR
- >> PIControllerL

_fsub (Thumb, 234 bytes, Stack size 16 bytes, faddsub_clz.o(x$fpl$fsub), UNUSED)

[Calls]

- >> __fpl_fnaninf
- >> _fadd1

### Local Symbols

MX_GPIO_Init (Thumb, 156 bytes, Stack size 48 bytes, main.o(i.MX_GPIO_Init))

[Stack]

- Max Depth = 88
- Call Chain = MX_GPIO_Init ⇒ HAL_GPIO_Init

[Calls]

- >> HAL_GPIO_WritePin
- >> HAL_GPIO_Init

[Called By]

- >> main

MX_TIM1_Init (Thumb, 100 bytes, Stack size 56 bytes, main.o(i.MX_TIM1_Init))

[Stack]

- Max Depth = 144
- Call Chain = MX_TIM1_Init ⇒ HAL_TIM_Encoder_Init ⇒ HAL_TIM_Encoder_MspInit ⇒ HAL_GPIO_Init

[Calls]

- >> HAL_TIM_Encoder_Init
- >> HAL_TIMEx_MasterConfigSynchronization
- >> __aeabi_memclr4

[Called By]

- >> main

MX_TIM2_Init (Thumb, 100 bytes, Stack size 56 bytes, main.o(i.MX_TIM2_Init))

[Stack]

- Max Depth = 144
- Call Chain = MX_TIM2_Init ⇒ HAL_TIM_Encoder_Init ⇒ HAL_TIM_Encoder_MspInit ⇒ HAL_GPIO_Init

[Calls]

- >> HAL_TIM_Encoder_Init
- >> HAL_TIMEx_MasterConfigSynchronization
- >> __aeabi_memclr4

[Called By]

- >> main

MX_TIM3_Init (Thumb, 94 bytes, Stack size 32 bytes, main.o(i.MX_TIM3_Init))

[Stack]

- Max Depth = 64
- Call Chain = MX_TIM3_Init ⇒ HAL_TIM_Base_Init ⇒ HAL_TIM_Base_MspInit ⇒ HAL_NVIC_SetPriority

[Calls]

- >> HAL_TIM_ConfigClockSource
- >> HAL_TIM_Base_Init
- >> HAL_TIMEx_MasterConfigSynchronization

[Called By]

- >> main

MX_TIM4_Init (Thumb, 150 bytes, Stack size 48 bytes, main.o(i.MX_TIM4_Init))

[Stack]

- Max Depth = 112
- Call Chain = MX_TIM4_Init ⇒ HAL_TIM_MspPostInit ⇒ HAL_GPIO_Init

[Calls]

- >> HAL_TIM_PWM_Init
- >> HAL_TIM_PWM_ConfigChannel
- >> HAL_TIM_MspPostInit
- >> HAL_TIMEx_MasterConfigSynchronization
- >> __aeabi_memclr4

[Called By]

- >> main

IntToUnicode (Thumb, 56 bytes, Stack size 20 bytes, usbd_desc.o(i.IntToUnicode))

[Stack]

- Max Depth = 20
- Call Chain = IntToUnicode

[Called By]

- >> USBD_FS_SerialStrDescriptor

CDC_Control_FS (Thumb, 4 bytes, Stack size 0 bytes, usbd_cdc_if.o(i.CDC_Control_FS))
[Address Reference Count : 1]

- usbd_cdc_if.o(.data)

CDC_DeInit_FS (Thumb, 4 bytes, Stack size 0 bytes, usbd_cdc_if.o(i.CDC_DeInit_FS))
[Address Reference Count : 1]

- usbd_cdc_if.o(.data)

CDC_Init_FS (Thumb, 24 bytes, Stack size 8 bytes, usbd_cdc_if.o(i.CDC_Init_FS))

[Stack]

- Max Depth = 8
- Call Chain = CDC_Init_FS

[Calls]

- >> USBD_CDC_SetTxBuffer
- >> USBD_CDC_SetRxBuffer

[Address Reference Count : 1]

- usbd_cdc_if.o(.data)

CDC_Receive_FS (Thumb, 150 bytes, Stack size 16 bytes, usbd_cdc_if.o(i.CDC_Receive_FS))

[Stack]

- Max Depth = 80
- Call Chain = CDC_Receive_FS ⇒ USBD_CDC_ReceivePacket ⇒ USBD_LL_PrepareReceive ⇒ HAL_PCD_EP_Receive ⇒ USB_EPStartXfer ⇒ USB_WritePMA

[Calls]

- >> USBD_CDC_SetRxBuffer
- >> USBD_CDC_ReceivePacket
- >> __aeabi_memclr
- >> __aeabi_memcpy

[Address Reference Count : 1]

- usbd_cdc_if.o(.data)

USBD_Get_USB_Status (Thumb, 24 bytes, Stack size 0 bytes, usbd_conf.o(i.USBD_Get_USB_Status))

[Called By]

- >> USBD_LL_Transmit
- >> USBD_LL_Start
- >> USBD_LL_StallEP
- >> USBD_LL_SetUSBAddress
- >> USBD_LL_PrepareReceive
- >> USBD_LL_OpenEP
- >> USBD_LL_CloseEP
- >> USBD_LL_ClearStallEP

HAL_PCD_EP_DB_Receive (Thumb, 230 bytes, Stack size 40 bytes, stm32f1xx_hal_pcd.o(i.HAL_PCD_EP_DB_Receive))

[Stack]

- Max Depth = 48
- Call Chain = HAL_PCD_EP_DB_Receive ⇒ USB_ReadPMA

[Calls]

- >> USB_ReadPMA

[Called By]

- >> PCD_EP_ISR_Handler

HAL_PCD_EP_DB_Transmit (Thumb, 824 bytes, Stack size 40 bytes, stm32f1xx_hal_pcd.o(i.HAL_PCD_EP_DB_Transmit))

[Stack]

- Max Depth = 128
- Call Chain = HAL_PCD_EP_DB_Transmit ⇒ HAL_PCD_DataInStageCallback ⇒ USBD_LL_DataInStage ⇒ USBD_CtlReceiveStatus ⇒ USBD_LL_PrepareReceive ⇒ HAL_PCD_EP_Receive ⇒ USB_EPStartXfer ⇒ USB_WritePMA

[Calls]

- >> USB_WritePMA
- >> HAL_PCD_DataInStageCallback

[Called By]

- >> PCD_EP_ISR_Handler

PCD_EP_ISR_Handler (Thumb, 940 bytes, Stack size 40 bytes, stm32f1xx_hal_pcd.o(i.PCD_EP_ISR_Handler))

[Stack]

- Max Depth = 168
- Call Chain = PCD_EP_ISR_Handler ⇒ HAL_PCD_EP_DB_Transmit ⇒ HAL_PCD_DataInStageCallback ⇒ USBD_LL_DataInStage ⇒ USBD_CtlReceiveStatus ⇒ USBD_LL_PrepareReceive ⇒ HAL_PCD_EP_Receive ⇒ USB_EPStartXfer ⇒ USB_WritePMA

[Calls]

- >> USB_ReadPMA
- >> USB_EPStartXfer
- >> HAL_PCD_EP_DB_Transmit
- >> HAL_PCD_EP_DB_Receive
- >> HAL_PCD_SetupStageCallback
- >> HAL_PCD_DataOutStageCallback
- >> HAL_PCD_DataInStageCallback

[Called By]

- >> HAL_PCD_IRQHandler

__NVIC_SetPriority (Thumb, 32 bytes, Stack size 0 bytes, stm32f1xx_hal_cortex.o(i.__NVIC_SetPriority))

[Called By]

- >> HAL_NVIC_SetPriority
- >> HAL_SYSTICK_Config

TIM_ITRx_SetConfig (Thumb, 16 bytes, Stack size 0 bytes, stm32f1xx_hal_tim.o(i.TIM_ITRx_SetConfig))

[Called By]

- >> HAL_TIM_ConfigClockSource

TIM_OC1_SetConfig (Thumb, 74 bytes, Stack size 12 bytes, stm32f1xx_hal_tim.o(i.TIM_OC1_SetConfig))

[Stack]

- Max Depth = 12
- Call Chain = TIM_OC1_SetConfig

[Called By]

- >> HAL_TIM_PWM_ConfigChannel

TIM_OC3_SetConfig (Thumb, 82 bytes, Stack size 12 bytes, stm32f1xx_hal_tim.o(i.TIM_OC3_SetConfig))

[Stack]

- Max Depth = 12
- Call Chain = TIM_OC3_SetConfig

[Called By]

- >> HAL_TIM_PWM_ConfigChannel

TIM_OC4_SetConfig (Thumb, 64 bytes, Stack size 12 bytes, stm32f1xx_hal_tim.o(i.TIM_OC4_SetConfig))

[Stack]

- Max Depth = 12
- Call Chain = TIM_OC4_SetConfig

[Called By]

- >> HAL_TIM_PWM_ConfigChannel

TIM_TI1_ConfigInputStage (Thumb, 34 bytes, Stack size 8 bytes, stm32f1xx_hal_tim.o(i.TIM_TI1_ConfigInputStage))

[Stack]

- Max Depth = 8
- Call Chain = TIM_TI1_ConfigInputStage

[Called By]

- >> HAL_TIM_ConfigClockSource

TIM_TI2_ConfigInputStage (Thumb, 36 bytes, Stack size 8 bytes, stm32f1xx_hal_tim.o(i.TIM_TI2_ConfigInputStage))

[Stack]

- Max Depth = 8
- Call Chain = TIM_TI2_ConfigInputStage

[Called By]

- >> HAL_TIM_ConfigClockSource

UART_DMAAbortOnError (Thumb, 16 bytes, Stack size 8 bytes, stm32f1xx_hal_uart.o(i.UART_DMAAbortOnError))

[Stack]

- Max Depth = 8
- Call Chain = UART_DMAAbortOnError

[Calls]

- >> HAL_UART_ErrorCallback

[Address Reference Count : 1]

- stm32f1xx_hal_uart.o(i.HAL_UART_IRQHandler)

UART_EndRxTransfer (Thumb, 78 bytes, Stack size 0 bytes, stm32f1xx_hal_uart.o(i.UART_EndRxTransfer))

[Calls]

- >> UART_EndRxTransfer

[Called By]

- >> HAL_UART_IRQHandler
- >> UART_EndRxTransfer

UART_Receive_IT (Thumb, 194 bytes, Stack size 8 bytes, stm32f1xx_hal_uart.o(i.UART_Receive_IT))

[Stack]

- Max Depth = 16
- Call Chain = UART_Receive_IT ⇒ HAL_UART_RxCpltCallback

[Calls]

- >> HAL_UART_RxCpltCallback
- >> HAL_UARTEx_RxEventCallback

[Called By]

- >> HAL_UART_IRQHandler

UART_SetConfig (Thumb, 178 bytes, Stack size 16 bytes, stm32f1xx_hal_uart.o(i.UART_SetConfig))

[Stack]

- Max Depth = 16
- Call Chain = UART_SetConfig

[Calls]

- >> HAL_RCC_GetPCLK2Freq
- >> HAL_RCC_GetPCLK1Freq

[Called By]

- >> HAL_UART_Init

USBD_GetDescriptor (Thumb, 232 bytes, Stack size 24 bytes, usbd_ctlreq.o(i.USBD_GetDescriptor))

[Stack]

- Max Depth = 88
- Call Chain = USBD_GetDescriptor ⇒ USBD_CtlSendData ⇒ USBD_LL_Transmit ⇒ HAL_PCD_EP_Transmit ⇒ USB_EPStartXfer ⇒ USB_WritePMA

[Calls]

- >> USBD_CtlSendData
- >> USBD_CtlError
- >> USBD_CtlSendStatus

[Called By]

- >> USBD_StdDevReq

USBD_SetConfig (Thumb, 128 bytes, Stack size 16 bytes, usbd_ctlreq.o(i.USBD_SetConfig))

[Stack]

- Max Depth = 80
- Call Chain = USBD_SetConfig ⇒ USBD_CtlSendStatus ⇒ USBD_LL_Transmit ⇒ HAL_PCD_EP_Transmit ⇒ USB_EPStartXfer ⇒ USB_WritePMA

[Calls]

- >> USBD_CtlError
- >> USBD_CtlSendStatus
- >> USBD_SetClassConfig
- >> USBD_ClrClassConfig

[Called By]

- >> USBD_StdDevReq

USBD_CDC_DataIn (Thumb, 70 bytes, Stack size 24 bytes, usbd_cdc.o(i.USBD_CDC_DataIn))

[Stack]

- Max Depth = 80
- Call Chain = USBD_CDC_DataIn ⇒ USBD_LL_Transmit ⇒ HAL_PCD_EP_Transmit ⇒ USB_EPStartXfer ⇒ USB_WritePMA

[Calls]

- >> USBD_LL_Transmit

[Address Reference Count : 1]

- usbd_cdc.o(.data)

USBD_CDC_DataOut (Thumb, 46 bytes, Stack size 16 bytes, usbd_cdc.o(i.USBD_CDC_DataOut))

[Stack]

- Max Depth = 16
- Call Chain = USBD_CDC_DataOut

[Calls]

- >> USBD_LL_GetRxDataSize

[Address Reference Count : 1]

- usbd_cdc.o(.data)

USBD_CDC_DeInit (Thumb, 68 bytes, Stack size 16 bytes, usbd_cdc.o(i.USBD_CDC_DeInit))

[Stack]

- Max Depth = 68
- Call Chain = USBD_CDC_DeInit ⇒ USBD_LL_CloseEP ⇒ HAL_PCD_EP_Close ⇒ USB_DeactivateEndpoint

[Calls]

- >> USBD_static_free
- >> USBD_LL_CloseEP

[Address Reference Count : 1]

- usbd_cdc.o(.data)

USBD_CDC_EP0_RxReady (Thumb, 36 bytes, Stack size 8 bytes, usbd_cdc.o(i.USBD_CDC_EP0_RxReady))

[Stack]

- Max Depth = 8
- Call Chain = USBD_CDC_EP0_RxReady

[Address Reference Count : 1]

- usbd_cdc.o(.data)

USBD_CDC_GetFSCfgDesc (Thumb, 8 bytes, Stack size 0 bytes, usbd_cdc.o(i.USBD_CDC_GetFSCfgDesc))
[Address Reference Count : 1]

- usbd_cdc.o(.data)

USBD_CDC_GetHSCfgDesc (Thumb, 8 bytes, Stack size 0 bytes, usbd_cdc.o(i.USBD_CDC_GetHSCfgDesc))
[Address Reference Count : 1]

- usbd_cdc.o(.data)

USBD_CDC_GetOtherSpeedCfgDesc (Thumb, 8 bytes, Stack size 0 bytes, usbd_cdc.o(i.USBD_CDC_GetOtherSpeedCfgDesc))
[Address Reference Count : 1]

- usbd_cdc.o(.data)

USBD_CDC_Init (Thumb, 148 bytes, Stack size 24 bytes, usbd_cdc.o(i.USBD_CDC_Init))

[Stack]

- Max Depth = 88
- Call Chain = USBD_CDC_Init ⇒ USBD_LL_OpenEP ⇒ HAL_PCD_EP_Open ⇒ USB_ActivateEndpoint

[Calls]

- >> USBD_static_malloc
- >> USBD_LL_PrepareReceive
- >> USBD_LL_OpenEP

[Address Reference Count : 1]

- usbd_cdc.o(.data)

USBD_CDC_Setup (Thumb, 172 bytes, Stack size 32 bytes, usbd_cdc.o(i.USBD_CDC_Setup))

[Stack]

- Max Depth = 96
- Call Chain = USBD_CDC_Setup ⇒ USBD_CtlPrepareRx ⇒ USBD_LL_PrepareReceive ⇒ HAL_PCD_EP_Receive ⇒ USB_EPStartXfer ⇒ USB_WritePMA

[Calls]

- >> USBD_CtlPrepareRx
- >> USBD_CtlSendData
- >> USBD_CtlError

[Address Reference Count : 1]

- usbd_cdc.o(.data)

_dadd1 (Thumb, 0 bytes, Stack size unknown bytes, daddsub_clz.o(x$fpl$dadd), UNUSED)

[Called By]

- >> _dsub

_dsub1 (Thumb, 0 bytes, Stack size unknown bytes, daddsub_clz.o(x$fpl$dsub), UNUSED)

[Called By]

- >> _dadd

_fadd1 (Thumb, 0 bytes, Stack size unknown bytes, faddsub_clz.o(x$fpl$fadd), UNUSED)

[Called By]

- >> _fsub

_fsub1 (Thumb, 0 bytes, Stack size unknown bytes, faddsub_clz.o(x$fpl$fsub), UNUSED)

[Called By]

- >> _fadd

### Undefined Global Symbols
