Chi68P1/Tennis_Ball_Retrieval_Robot_Project/Mạch điện.pdf

1/4/2024

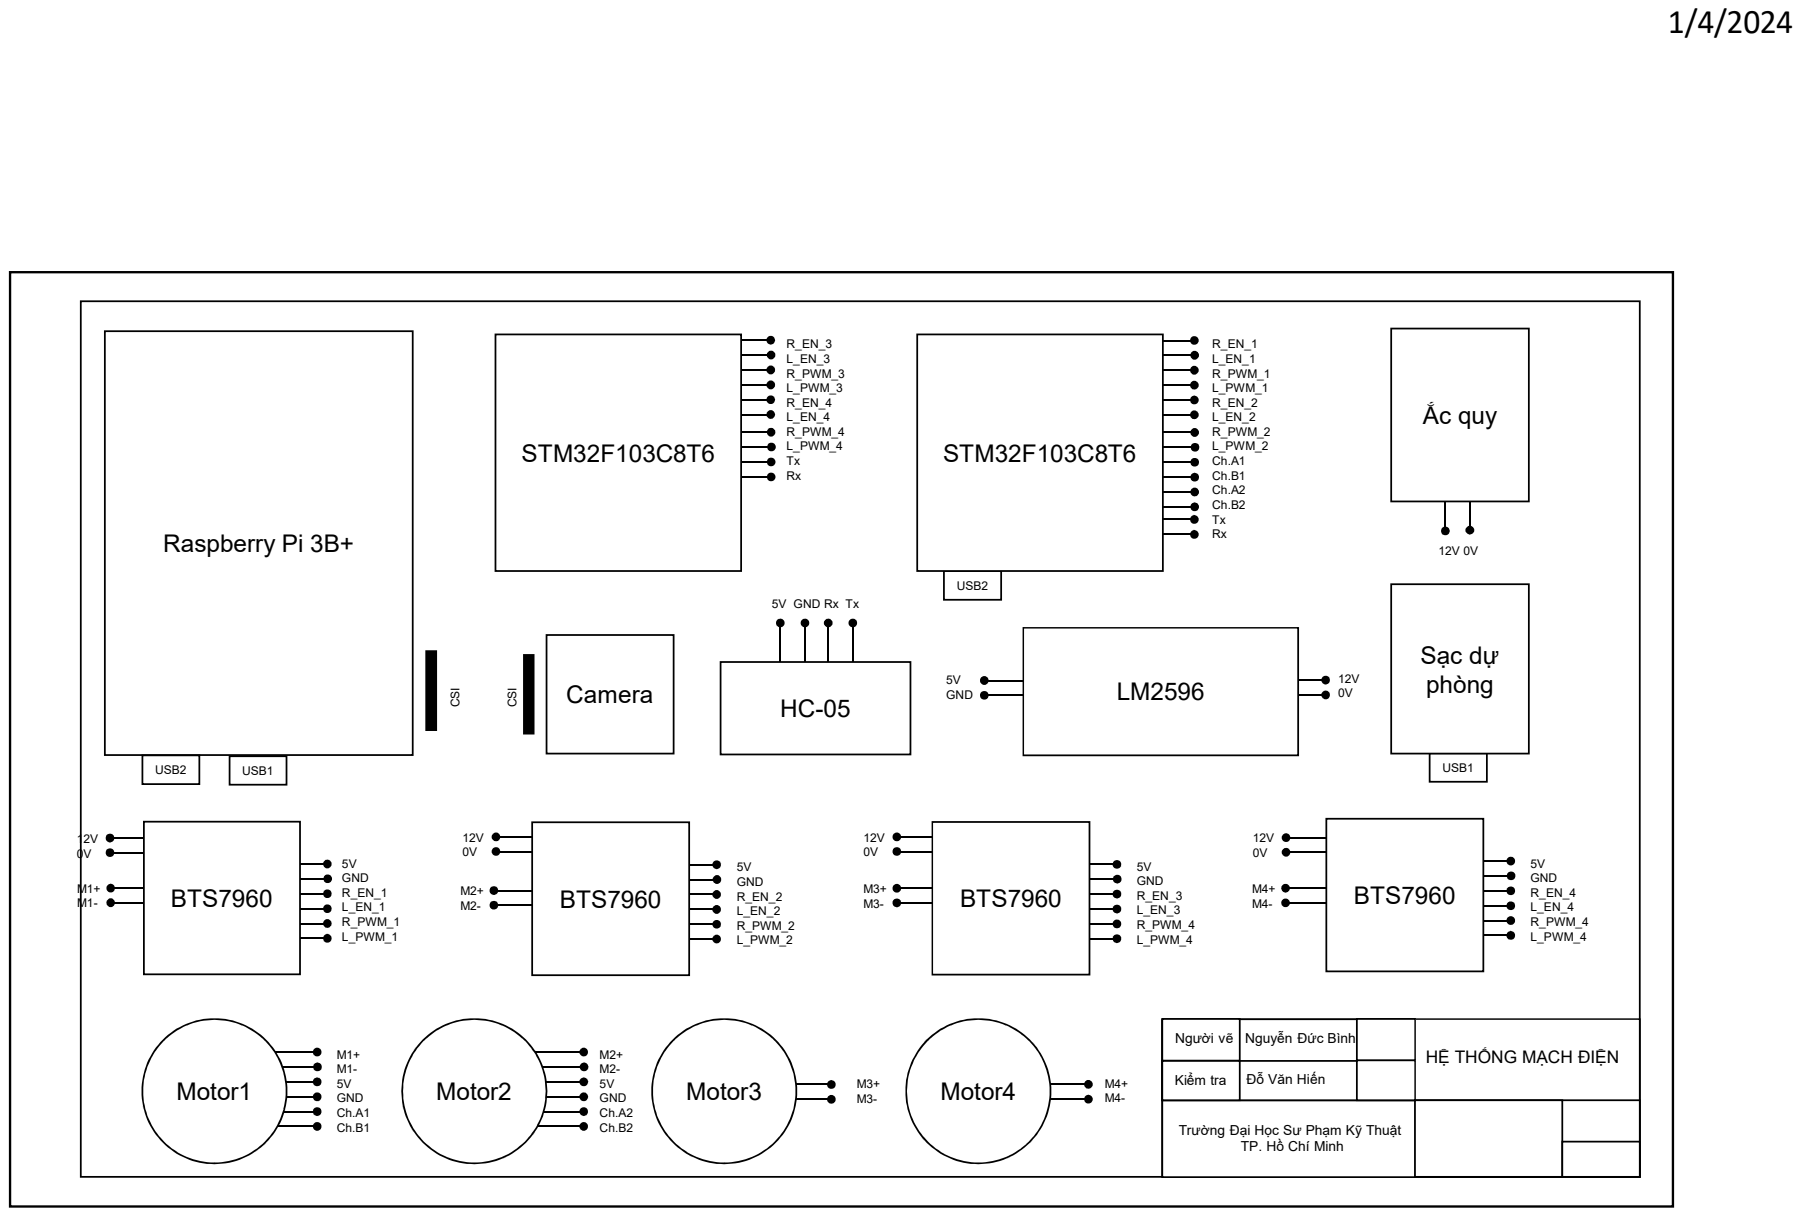
[picture p67: page 1]
Raspberry Pi 3B+; CSI; Camera; Motor1; Motor2; Motor3; Motor4; M2+ M2- 5V GND Ch.A2 Ch.B2; M1+ M1- 5V GND Ch.A1 Ch.B1; 5V GND R_EN_2 L_EN_2 R_PWM_2 L_PWM_2; 5V GND R_EN_3 L_EN_3 R_PWM_4 L_PWM_4; 5V GND R_EN_4 L_EN_4 R_PWM_4 L_PWM_4; STM32F103C8T6; Ắc quy; USB1; Sạc dự phòng; USB2; LM2596 ⁵V GND; 5V GND R_EN_1 L_EN_1 R_PWM_1 L_PWM_1; R_EN_1 L_EN_1 R_PWM_1 L_PWM_1 R_EN_2 L_EN_2 R_PWM_2 L_PWM_2 Ch.A1 Ch.B1 Ch.A2 Ch.B2 Tx Rx; R_EN_3 L_EN_3 R_PWM_3 L_PWM_3 R_EN_4 L_EN_4 R_PWM_4 L_PWM_4 Tx Rx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

5V GND Rx Tx

Nguyễn Đức Bình

HỆ THỐNG MẠCH ĐIỆN

Đỗ Văn Hiến

Trường Đại Học Sư Phạm Kỹ Thuật

TP. Hồ Chí Minh
