Chi68P1/Tennis_Ball_Retrieval_Robot_Project/SW_stm32/Manual_stm_1/Core/Src/main.c

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
/* Includes ------------------------------------------------------------------*/
#include "main.h"
#include "usb_device.h"

/* USER CODE BEGIN Includes */
#include "usbd_cdc_if.h"
/* USER CODE END Includes */

/* USER CODE BEGIN PD */
#define UPDATE_PERIOD			0.005		/* Chu ki cap nhat: 5ms = ngat timer 4 */
#define PULSES_IN_ROUND		249.6		/* So xung tren 1 vong cua dong co = 13 xung x ti so truyen 19.2 */
/* USER CODE END PD */

TIM_HandleTypeDef htim1;
TIM_HandleTypeDef htim2;
TIM_HandleTypeDef htim3;
TIM_HandleTypeDef htim4;

UART_HandleTypeDef huart3;

/* USER CODE BEGIN PV */
char Rx_indx, Rx_Buffer[20],Rx_data[2];

/* Parameter of USB USB receive */
uint8_t 	buffer[64];
uint8_t		RunSystem 				= 0;						/* ON/OFF all system */
int16_t		DesiredRightSpeed  	= 0;					/* Van toc mong muon banh trai (rpm) */
int16_t		DesiredLeftSpeed 	= 0;						/* Van toc mong muon banh phai (rpm) */
float			DesiredRightVel  	= 0;						/* Van toc mong muon banh trai (rad/s) */
float			DesiredLeftVel  	= 0;						/* Van toc mong muon banh phai (rad/s) */
uint8_t		EnablePickup 			= 0;						/* ON/OFF pickup system */

int16_t pwmL;
int16_t pwmR;


/* Parameter of PIController */
float 		Kp 							= 1.609746269;				/* Ti le */
float 		Ki 							= 29.85074627;				/* Tich phan */
float 		Kd 							= 0.0;								/* Vi phan */
float			Kb 							= 18.54375863;				/* Dung cho Anti-windup */

int32_t 	UHiLim 					= 100;								/* Gioi han tren pwm */
int32_t 	ULoLim 					= -100;									/* Gioi han duoi pwm */

/* Parameter of HAL_TIM_PeriodElapsedCallback */
int16_t 	VelCntL     		= 0;			/* Bien dem encoder => tinh van toc */
float 		CurrVelL 				= 0;	 		/* Van toc hien tai (Rad/s) */
int16_t 	CurrSpeedL	 			= 0;	 		/* Van toc hien tai (RPM) */

int16_t 	VelCntR      		= 0;			/* Bien dem encoder => tinh van toc */
float 		CurrVelR 				= 0;	 		/* Van toc hien tai (Rad/s) */
int16_t 	CurrSpeedR	 			= 0;	 		/* Van toc hien tai (RPM) */

uint16_t 	tick						= 0;			/* Dung de dem cho timer 5 */

/* USER CODE END PV */

void SystemClock_Config(void);
static void MX_GPIO_Init(void);
static void MX_TIM1_Init(void);
static void MX_TIM2_Init(void);
static void MX_TIM3_Init(void);
static void MX_TIM4_Init(void);
static void MX_USART3_UART_Init(void);
/* USER CODE BEGIN 0 */


/* ======================================================================================= USB printf ======================================================================================= */
struct __FILE
{
  int handle;
  /* Whatever you require here. If the only file you are using is */
  /* standard output using printf() for debugging, no file handling */
  /* is required. */
};
/* FILE is typedef'd in stdio.h. */
FILE __stdout;
int fputc(int ch, FILE *f)
{	
    while(!(CDC_Transmit_FS((uint8_t*)&ch, 1) == USBD_OK))
        ;
    return ch;
}
/* ======================================================================================= End USB printf ======================================================================================= */

/* ======================================================================================= UART Bluetooth ======================================================================================= */

void HAL_UART_RxCpltCallback(UART_HandleTypeDef *huart)
	{
		uint8_t i;
		if(huart->Instance == USART3) //uart1
		{
		switch(Rx_data[0]) {
						case '7':
								RunSystem = 1;
                break;
						case '8':
								RunSystem = 0;
                break;
            case '1':
								DesiredLeftSpeed = 30;
								DesiredRightSpeed =30;
                break;
            case '2':
								DesiredLeftSpeed = -30;
								DesiredRightSpeed = -30;
                break;
						case '3':
								DesiredLeftSpeed = -20;
								DesiredRightSpeed = 20;
                break;
            case '4':
								DesiredLeftSpeed = 20;
								DesiredRightSpeed = -20;
                break;
						case '0':
								DesiredLeftSpeed = 0;
								DesiredRightSpeed = 0;
                break;

            default:
                break;
        }
				HAL_UART_Receive_IT(&huart3,(uint8_t*)Rx_data,1);
		}
	}
/* ======================================================================================= End UART Bluetooth ======================================================================================= */
	
/* ================================================================================ PI Controller +(Anti-windup) ================================================================================ */
int32_t PIControllerL(float desired_val, float real_val, float gain, float Ki, float Kb, int uHiLim, int uLoLim)
{
		/* Controller values */
		static float err_reset;
		static float uI_p;
		float err, uP, uI;
		int uOut;
		
		/* Algorithm */
		err = (desired_val - real_val);
			/* Proportional */
		uP = gain * err;
			/* Integral (with Anti-windup) */
		uI = uI_p + (Ki * UPDATE_PERIOD *err) + Kb * UPDATE_PERIOD * err_reset;
			/* Integral part */
		uI_p = uI;
			/* Output control */
		uOut = (int)(uP + uI);
			/* Output saturation */
		if(uOut >= uHiLim)
		{
			err_reset = uHiLim - uOut;
			uOut = uHiLim;
		}
		else if(uOut <= uLoLim)
		{
			err_reset = uLoLim - uOut;
			uOut = uLoLim;
		}
		return uOut;
}

int32_t PIControllerR(float desired_val, float real_val, float gain, float Ki, float Kb, int uHiLim, int uLoLim)
{
		/* Controller values */
		static float err_reset;
		static float uI_p;
		float err, uP, uI;
		int uOut;
		
		/* Algorithm */
		err = (desired_val - real_val);
			/* Proportional */
		uP = gain * err;
			/* Integral (with Anti-windup) */
		uI = uI_p + (Ki * UPDATE_PERIOD *err) + Kb * UPDATE_PERIOD * err_reset;
			/* Integral part */
		uI_p = uI;
			/* Output control */
		uOut = (int)(uP + uI);
			/* Output saturation */
		if(uOut >= uHiLim)
		{
			err_reset = uHiLim - uOut;
			uOut = uHiLim;
		}
		else if(uOut <= uLoLim)
		{
			err_reset = uLoLim - uOut;
			uOut = uLoLim;
		}
		return uOut;
}
/* ============================================================================== End PI Controller +(Anti-windup) ============================================================================== */
 
/* ================================================================================ Motor Control ================================================================================ */
void MotorLeftRot(int32_t pwmSet)
{
	HAL_GPIO_WritePin(GPIOA, GPIO_PIN_3, 1);
	HAL_GPIO_WritePin(GPIOA, GPIO_PIN_4, 1);
	if (pwmSet > 0) {
		__HAL_TIM_SetCompare(&htim4, TIM_CHANNEL_1, pwmSet);
		__HAL_TIM_SetCompare(&htim4, TIM_CHANNEL_2, 0);
	}
	else if (pwmSet < 0) {
		__HAL_TIM_SetCompare(&htim4, TIM_CHANNEL_1,0);
		__HAL_TIM_SetCompare(&htim4, TIM_CHANNEL_2, -pwmSet);
	}
	else{
		HAL_GPIO_WritePin(GPIOA, GPIO_PIN_3, 0);
		HAL_GPIO_WritePin(GPIOA, GPIO_PIN_4, 0);
	}
}
void MotorRightRot(int32_t pwmSet)
{
	HAL_GPIO_WritePin(GPIOA, GPIO_PIN_5, 1);
	HAL_GPIO_WritePin(GPIOA, GPIO_PIN_6, 1);
	if (pwmSet > 0) {
		__HAL_TIM_SetCompare(&htim4, TIM_CHANNEL_3, pwmSet);
		__HAL_TIM_SetCompare(&htim4, TIM_CHANNEL_4, 0);
	}
	else if (pwmSet < 0) {
		__HAL_TIM_SetCompare(&htim4, TIM_CHANNEL_3,0);
		__HAL_TIM_SetCompare(&htim4, TIM_CHANNEL_4, -pwmSet);
	}
	else{
		HAL_GPIO_WritePin(GPIOA, GPIO_PIN_5, 0);
		HAL_GPIO_WritePin(GPIOA, GPIO_PIN_6, 0);
	}
}
/* ============================================================================== End Motor Control ============================================================================== */


/* USER CODE END 0 */

/**
  * @brief  The application entry point.
  * @retval int
  */
int main(void)
{
  /* MCU Configuration--------------------------------------------------------*/

  /* Reset of all peripherals, Initializes the Flash interface and the Systick. */
  HAL_Init();

  /* Configure the system clock */
  SystemClock_Config();

  /* Initialize all configured peripherals */
  MX_GPIO_Init();
  MX_TIM1_Init();
  MX_TIM2_Init();
  MX_TIM3_Init();
  MX_TIM4_Init();
  MX_USB_DEVICE_Init();
  MX_USART3_UART_Init();
  /* USER CODE BEGIN 2 */
	HAL_TIM_PWM_Start(&htim4, TIM_CHANNEL_1);	// start  timer 1 	
	HAL_TIM_PWM_Start(&htim4, TIM_CHANNEL_2);	// start 	timer 1
	HAL_TIM_PWM_Start(&htim4, TIM_CHANNEL_3);	// start  timer 1 	
	HAL_TIM_PWM_Start(&htim4, TIM_CHANNEL_4);	// start 	timer 1
	HAL_TIM_Base_Start_IT(&htim3);						// start  timer 3
	HAL_TIM_Encoder_Start(&htim1, TIM_CHANNEL_ALL); // start encode mode
	HAL_TIM_Encoder_Start(&htim2, TIM_CHANNEL_ALL); // start encode mode
	HAL_UART_Receive_IT(&huart3,(uint8_t*)Rx_data,1);	
  /* USER CODE END 2 */

  /* Infinite loop */
  /* USER CODE BEGIN WHILE */
  while (1)
  {
    /* USER CODE END WHILE */
		MotorRightRot(30);
		VelCntR		=__HAL_TIM_GET_COUNTER(&htim2);
		MotorLeftRot(30);
		VelCntL		=__HAL_TIM_GET_COUNTER(&htim1);
    /* USER CODE BEGIN 3 */
  }
  /* USER CODE END 3 */
}

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
/* USER CODE BEGIN 4 */

/* ====================================================================== Timer Interrupt ====================================================================== */
void HAL_TIM_PeriodElapsedCallback(TIM_HandleTypeDef *htim) {	

	if(htim->Instance==TIM3)																												/* Ngat timer 3: 5ms */
	{	
		DesiredLeftVel = DesiredLeftSpeed*2*3.1415/60;																/* rad/s */	
		DesiredRightVel = DesiredRightSpeed*2*3.1415/60;															/* rad/s */	

		if (RunSystem ==1) {			
			VelCntL			=__HAL_TIM_GET_COUNTER(&htim1);																		/* Lay gia tri count velocity */		
			__HAL_TIM_SET_COUNTER(&htim1, 0);                                 						/* Reset cnt */      
			CurrSpeedL 	= 60*VelCntL/(4*PULSES_IN_ROUND*UPDATE_PERIOD);										/* RPM */				
			CurrVelL 		= 2*3.1415*VelCntL/(4*PULSES_IN_ROUND*UPDATE_PERIOD);							/* rad/s */	
			pwmL = PIControllerL(DesiredLeftVel, CurrVelL, Kp, Ki, Kb, UHiLim, ULoLim);		/* caculate pwm */
			MotorLeftRot(pwmL);																														/* Control left motor */
			
			VelCntR			=__HAL_TIM_GET_COUNTER(&htim2);																		/* Lay gia tri count velocity */		
			__HAL_TIM_SET_COUNTER(&htim2, 0);                                 						/* Reset cnt */      
			CurrSpeedR 	= 60*VelCntR/(4*PULSES_IN_ROUND*UPDATE_PERIOD);										/* RPM */				
			CurrVelR 		= 2*3.1415*VelCntR/(4*PULSES_IN_ROUND*UPDATE_PERIOD);							/* rad/s */
			pwmR = PIControllerR(DesiredRightVel, CurrVelR, Kp, Ki, Kb, UHiLim, ULoLim);	/* caculate pwm */
			MotorRightRot(pwmR);																													/* Control right motor */
		}
		else {
			__HAL_TIM_SET_COUNTER(&htim1, 0);  
			__HAL_TIM_SET_COUNTER(&htim2, 0);  
			pwmL = 0;
			pwmR = 0;
			MotorLeftRot(pwmL);																														/* Control left motor */
			MotorRightRot(pwmR);																													/* Control right motor */																												
		}
	return;
	}
}
/* ====================================================================== End Timer Interrupt ====================================================================== */

/* USER CODE END 4 */
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
