Chi68P1/Tennis_Ball_Retrieval_Robot_Project/(notices)

Notices in the files:
SW_stm32/Manual_stm_1/Core/Src/main.c:
Copyright (c) 2023 STMicroelectronics.
All rights reserved.
This software is licensed under terms that can be found in the LICENSE file
